tokai-student-rocket-project/H-57-Avionics/README.md

# H-57 搭載計器





TSRP-H-57に搭載する計器類のプログラム及び設計書を保存するレポジトリです。

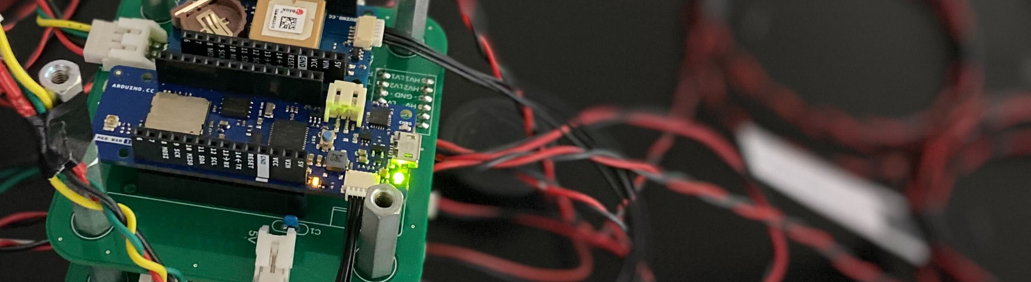
[picture p1: Documents/Images/Hero.png]
Hero


## はじめに

学生ロケットの電装系を盛り上げたい思いから、全てのソースコードを含む設計を公開しています。ガバガバ開発ですので、分かりにくい点（資料がまとまっていないなど）が多々あります。ご了承ください。

ご不明な点は以下のSNSからお気軽にお問合せください。

- X (旧Twitter): [@Tokai_SRP](https://twitter.com/Tokai_SRP)

### 計器の概要

H-57搭載計器は新型共通計器基板、テレメータ基板、バルブ制御基板および、電源基板から構成されます。

### レポジトリ構成

#### ./FlightComponents/

- [新型共通計器](./FlightComponents/CommonInstrument/README.md)   
- [テレメータ](./FlightComponents/Telemeter/README.md)  
- [バルブ制御](./FlightComponents/Telemeter/README.md) 
- 電源 

#### ./FlightResult/

- [解析資料](./FlightResult/CommonInstrument/H-57_Avionics_Analysis.md)
