tokai-student-rocket-project/H-57-Avionics/FlightComponents/Telemeter/Hardware/ServoContoroller.png

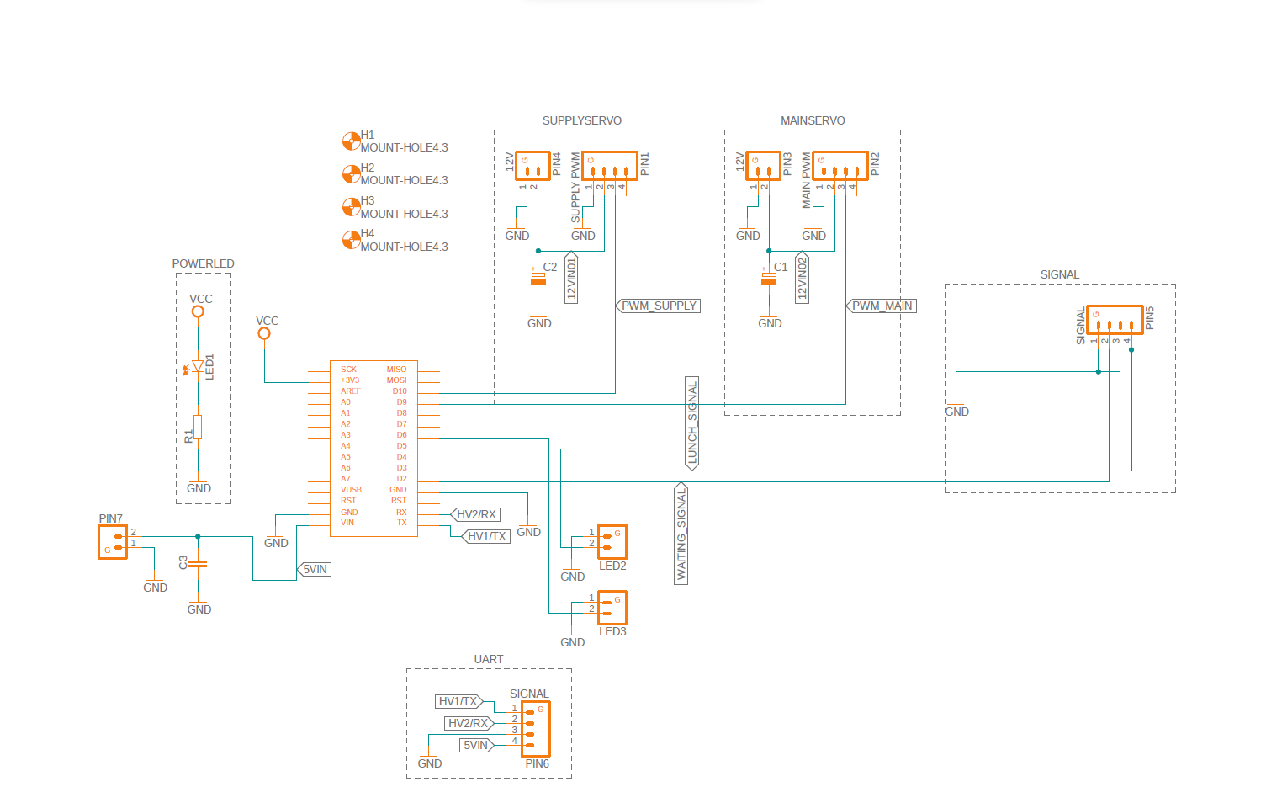
FlightComponents/Telemeter/Hardware/ServoContoroller.png
