tokai-student-rocket-project/H-57-Avionics/FlightComponents/Telemeter/Hardware/ServoController_Bottom.png

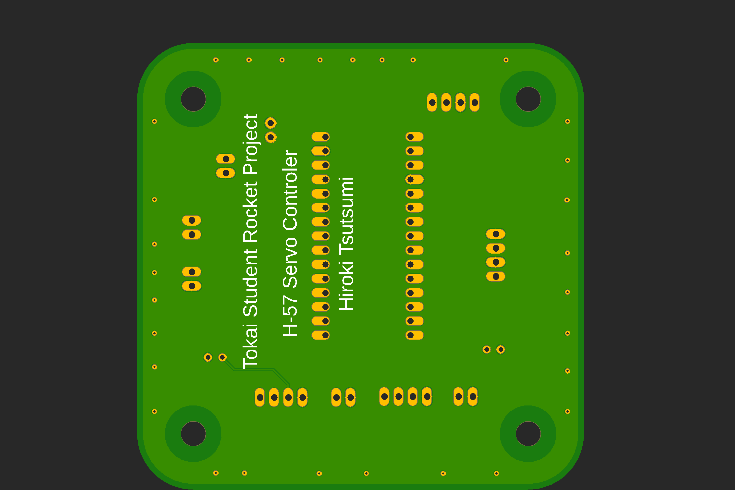
FlightComponents/Telemeter/Hardware/ServoController_Bottom.png
