tokai-student-rocket-project/H-57-Avionics/FlightComponents/Telemeter/Hardware/ServoController_Top.png

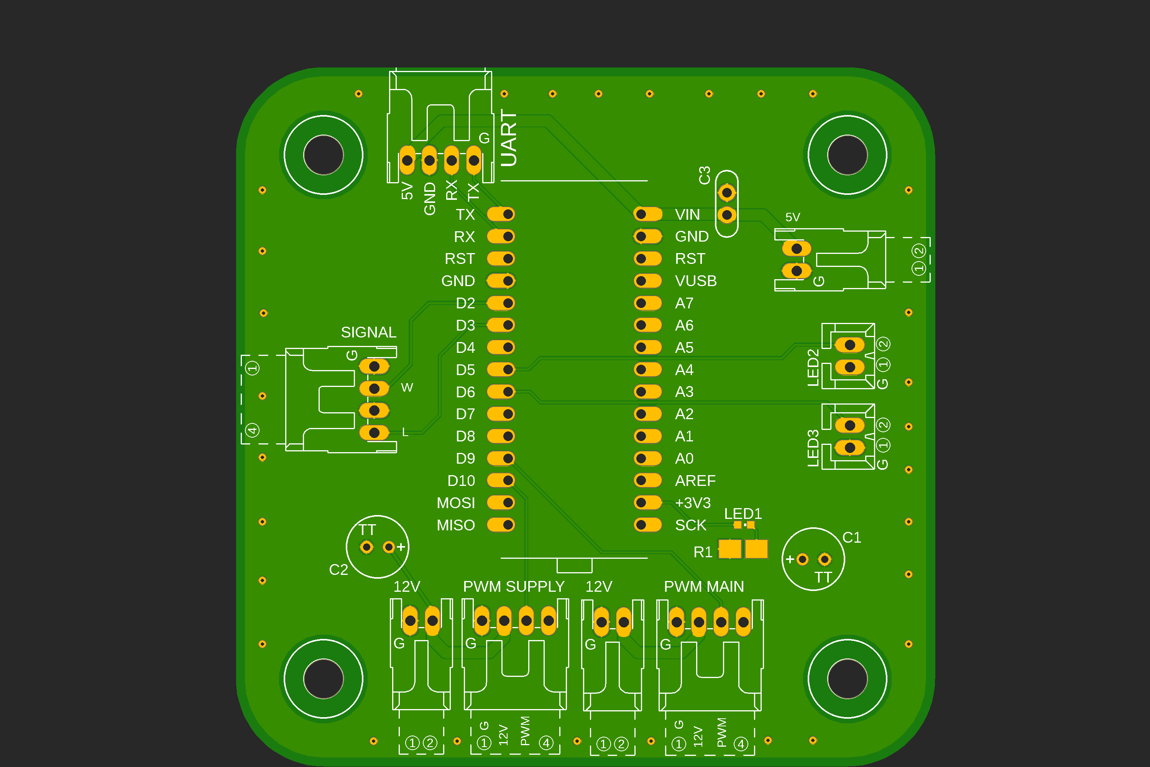
FlightComponents/Telemeter/Hardware/ServoController_Top.png
