tokai-student-rocket-project/H-57-Avionics/FlightComponents/Telemeter/README.md

# 目次

- [目次](#目次)
- [概要](#概要)
    - [目的](#目的)
    - [特徴](#特徴)
    - [成功基準](#成功基準)
- [H-57](#h-57)
  - [テレメトリー基板](#テレメトリー基板)
    - [仕様（テレメトリー基板）](#仕様テレメトリー基板)
    - [作業手順書（テレメトリー基板）](#作業手順書テレメトリー基板)
  - [バルブコントローラー基板](#バルブコントローラー基板)
    - [仕様（バルブコントローラー基板）](#仕様バルブコントローラー基板)
    - [作業手順書（バルブコントローラー基板）](#作業手順書バルブコントローラー基板)

# 概要

### 目的

- 酸化剤供給用バルブと主流路用バルブの制御を行う
- 位置情報を取得しロケットの現在地を地上に送信する

### 特徴

- 使用するマイコンボードにArduinoを採用
  
  → プログラミング初学者でも比較的作成が容易！

  → 拡張性・運用性・保守性が向上！
- LoRaWANの搭載
  - 簡単なプログラムで見通し10km以上の通信が可能
  
### 成功基準

| MINIMUM | 
| - | 
| ・GPSダウンリンク可能な機器の作成 |
| ・自作基板でのテレメーター作成 |

| FULL |
| - | 
| ・引継ぎ資料のマニュアル作成 |
| ・各種評価試験のマニュアル作成 |

| ADVANCED |
| - | 
|・送信データの種類の追加 |
|・アップリンク検証 |

[目次へ戻る](#目次)
***

# H-57

<!--何か説明やCADイメージ、現地の写真を挿入できたらいいな～-->

## テレメトリー基板

### 仕様（テレメトリー基板）

- ハードウェア

  - マイコンボード
    - [MKR WAN 1310](https://docs.arduino.cc/hardware/mkr-wan-1310)（Arduino公式HPより）
  - 動作電圧
    - USB給電：5.0V
    - 外部給電：5.0V
  - Shield
    - [MKR GPS Shield](https://docs.arduino.cc/hardware/mkr-gps-shield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.)（Arudino公式HPより）
      - バックアップ電池：CR1216

- ソフトウェア

  - 使用したライブラリ
    - [Arduino_MKRGPS.h](https://github.com/arduino-libraries/Arduino_MKRGPS)
      - MKR GPS Shield用のライブラリです。緯度、経度だけでなく受信した衛星の数や速度も取得できます。
    - [LoRa.h](https://github.com/sandeepmistry/arduino-LoRa)
      - LoRa(Low Power Wide Area)の一種。通信規格のこと。
      - LoRaで通信する際に必要なライブラリ
    - [SPI.h](https://www.arduino.cc/reference/en/language/functions/communication/spi/)
      - SPI通信をする際に必要なライブラリ
    - [ArduinoJson.h](https://github.com/bblanchon/ArduinoJson)
      - [公式HP](https://arduinojson.org/)
      - Json形式で値のやり取りができるようになるライブラリ
  - [**Inside.ino**](https://github.com/tokai-student-rocket-project/Avionics/tree/main/FlightComponents/Telemeter/Inside)
    - H-57に搭載するテレメトリー基板に使用するソースコード（名前がダサいのは直すかもしれないです...）

- 取得するデータ
  - 緯度
  - 経度
  - Epoch Time
  - 供給用バルブの角度
  - 主流路バルブの角度

- 動作
  - 電源投入後、屋外であれば3分ほど、屋内であれば7分ほどで現在の位置情報を受信開始します。
    - 正常に受信し、送信を開始するとGPS受信確認用LED（**青色**）が点滅します。
  - 各種バルブの角度は電源投入後から送信を開始します。
    - UART通信が正常に行われている場合、UART確認用LED（**緑色**）が点灯します。
  - 飛翔中に各種データの取得が可能かどうかは打ち上げを行っていない現時点では未確認です。　

### 作業手順書（テレメトリー基板）
- 事前準備

  1. USB-microB - 自身のPCにあう端子のケーブル（以後、USB-microBケーブル）、***MKR WAN 1310***、***MKR GPS Shield***を用意してください。
  2. USB-microB ケーブルを***MKR WAN 1310***に接続してください。 
  3. [Inside.ino](https://github.com/tokai-student-rocket-project/Avionics/tree/main/FlightComponents/Telemeter/Inside) を ***MKR WAN 1310*** へ書き込んで下さい。書き込み後、USB-microBケーブルを取り外してください。
  4. 基板へ iii. で書き込んだ ***MKR WAN 1310*** を**向きに気をつけて**取り付けてください。
  5. ***MKR GPS Shield*** を基板へ向きに気をつけて取り付けてください。

- タワーの組み立て
  - [こちら](./docs/Manual_Telematar.md)を参照してください。

[目次へ戻る](#目次)
***

## バルブコントローラー基板
### 仕様（バルブコントローラー基板）
- ハードウェア
  - マイコンボード
    - [ARDUINO NANO](https://docs.arduino.cc/hardware/nano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.)（Arduino公式HPより）

  - 動作電圧
    - USB給電:5.0V
    - 外部給電:5.0V
  - アクチュエータ
    - [RS-405CB](https://www.futaba.co.jp/product/robot/command_type_servos/rs405cb)（Futaba公式HPより）
      - 電源電圧:11.1[V]
      - トルク:48.0[kgf.cm]
      - スピード:0.22[s/60°]
      - 可動範囲:300[deg]
- ソフトウェア
  - [VarSpeedServo](https://github.com/netlabtoolkit/VarSpeedServo)
    - アクチュエータの角度、速度を制御します。
  - [ArduinoJson.h](https://github.com/bblanchon/ArduinoJson)
      - [公式HP](https://arduinojson.org/)
      - Json形式で値のやり取りができるようになるライブラリ

- 動作
  - GSEからの信号を取得し、バルブを制御します。
    - GSEからバルブ開の信号を取得すると供給用バルブ（常開）が**閉栓**し、主流路バルブ（常閉）が**開栓**します。
      - この状態を**Launch Mode**と呼称します。
        - Launch Mode時は状態確認用LED（**赤色**）が点灯します。
    - GSEからバルブ閉の信号を取得すると供給用バルブ（常開）が**開栓**し、主流路バルブ（常閉）が**閉栓**します。
      - この状態を**Waiting Mode**と呼称します。
      - バルブコントローラー基板起動時や特に信号がない時は**Waiting Mode**になっています。
        - Waiting Mode時は状態確認用LED（**緑色**）が点灯します。
  - UART通信用ケーブルが接続されている間はテレメトリー基板と通信を行いサーボモーターの角度を送信しています。

  工事中

### 作業手順書（バルブコントローラー基板）
- 事前準備
  1. USB-MiniB - 自身のPCにあう端子のケーブル（以後、USB-MiniBケーブル）、***Arduino NANO***を用意してください。
  2. USB-MiniB ケーブルを***Arduino NANO***に接続してください。 
  3. [ValveContoroler](/FlightComponents/Telemeter/ValveContoroler) 内にあるすべてのファイルをフォルダごとダウンロードしてください。
  4. [ValveContoroler.ino](/FlightComponents/Telemeter/ValveContoroler/ValveContoroler.ino) を ***Arduino NANO*** へ書き込んで下さい。書き込み後、USB-MiniBケーブルを取り外してください。
  5. 基板へ iv.で書き込んだ ***Arduino NANO*** を**向きに気をつけて**取り付けてください。
- タワーの組立
  - [こちら](./docs/Manual_ValveContoroler.md)を参照してください。

[目次へ戻る](#目次)

***

工事中
