tokai-student-rocket-project/H-57-Avionics/FlightComponents/CommonInstrument/docs/materials/CDR/H-57新型共通計器CDR資料.pdf

‘22年度 冬季打ち上げ CDR
H-57

# 新型共通計器

担当

岩井 祐樹 (2CEU1107)

目次

- 概要• 共通計器の目的 • 新型共通計器の特徴 • 成功基準 • 仕様• ハードウェア構成 • データ処理 • フライトモード • 分離ロジック • 通信システム
- 地上ソフトウェア • 検討事項 • 進捗状況 • ガントチャート

1/15

## 概要 / 共通計器の目的

- 分離機構に分離信号を送る
- 飛行データの取得と記録を行う

2/15

## 概要 / 新型共通計器の特徴

- マイコンにArduinoを採用

→ 拡張性・運用性・保守性が向上

- フライトモードによる指定高度分離

→ 落下分散の縮小が期待できる

- 双方向無線通信システム

→ 地上ソフトウェアを使用してコンフィグ設定・状態監視が可能

3/15

# 成功基準

- MIN: タイマーによる強制分離 • FULL: 指定高度での分離 • ADV: 双方向無線通信の正常動作

4/15

## 仕様 / ハードウェア構成

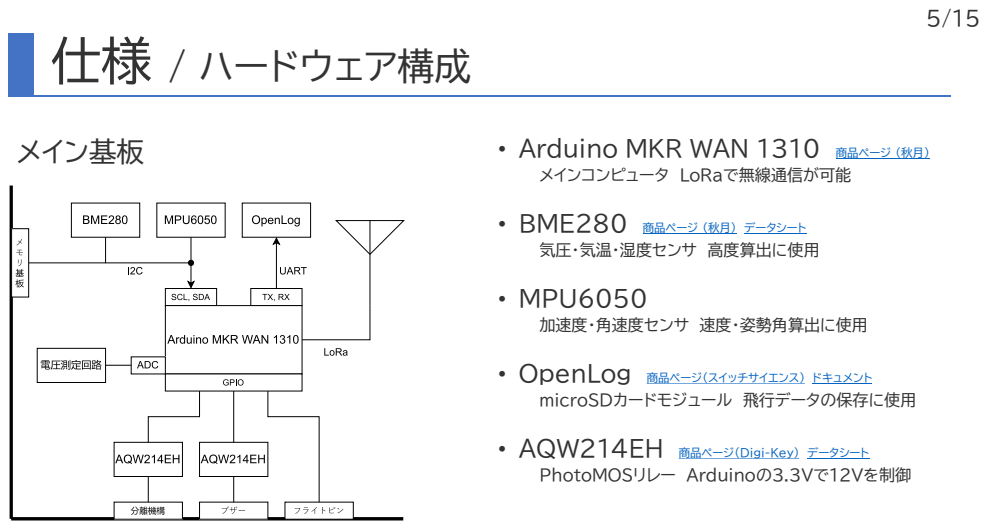
[picture p11: page 6]
メイン基板

• Arduino MKR WAN 1310 商品ページ (秋月) (https://akizukidenshi.com/catalog/g/gM-16557/)
メインコンピュータ LoRaで無線通信が可能

• BME280 商品ページ (秋月) (https://akizukidenshi.com/catalog/g/gK-09421/) データシート (https://akizukidenshi.com/download/ds/bosch/BST-BME280_DS001-10.pdf)
気圧・気温・湿度センサ 高度算出に使用

• MPU6050
加速度・角速度センサ 速度・姿勢角算出に使用

• OpenLog 商品ページ(スイッチサイエンス) (https://www.switch-science.com/products/2716) ドキュメント (https://github.com/sparkfun/OpenLog/wiki)
microSDカードモジュール 飛行データの保存に使用

• AQW214EH 商品ページ(Digi-Key) (https://www.digikey.jp/ja/products/detail/panasonic-electric-works/AQW214EH/512354) データシート (https://www3.panasonic.biz/ac/e_download/control/relay/photomos/catalog/semi_eng_ge2a_aqw21_e.pdf)
PhotoMOSリレー Arduinoの3.3Vで12Vを制御

## 仕様 / ハードウェア構成

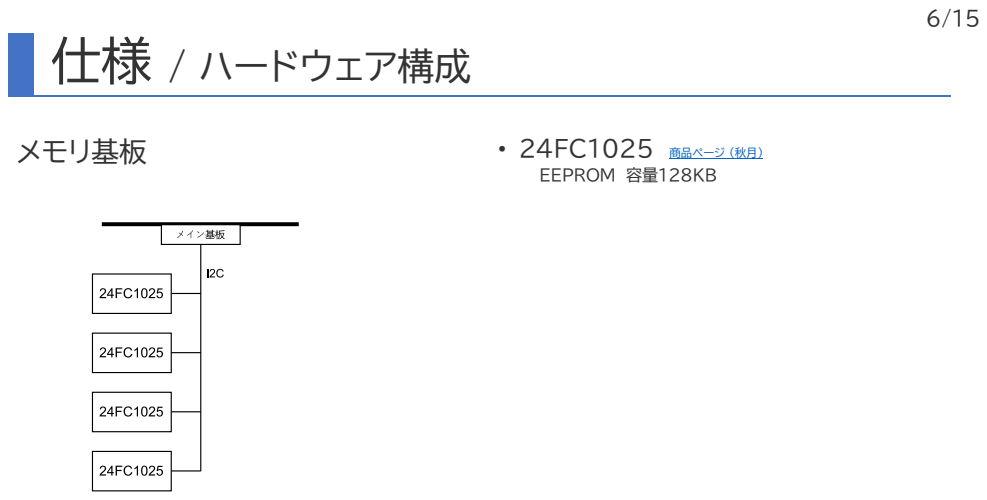
[picture p12: page 7]
• 24FC1025 商品ページ (秋月); EEPROM 容量128KB; メモリ基板

## 仕様 / ハードウェア構成

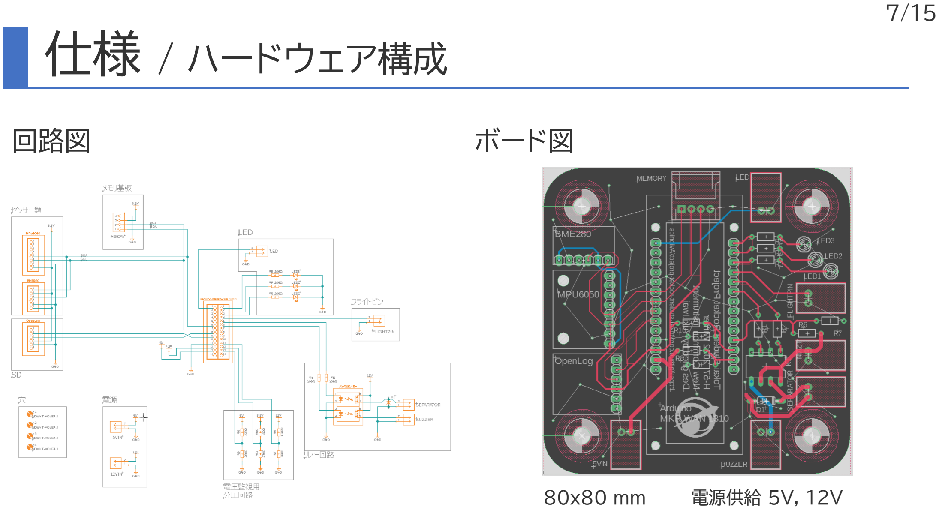
[picture p13: page 8]

ボード図

7/15

回路図

80x80 mm 電源供給 5V, 12V

## 仕様 / データ処理

8/15

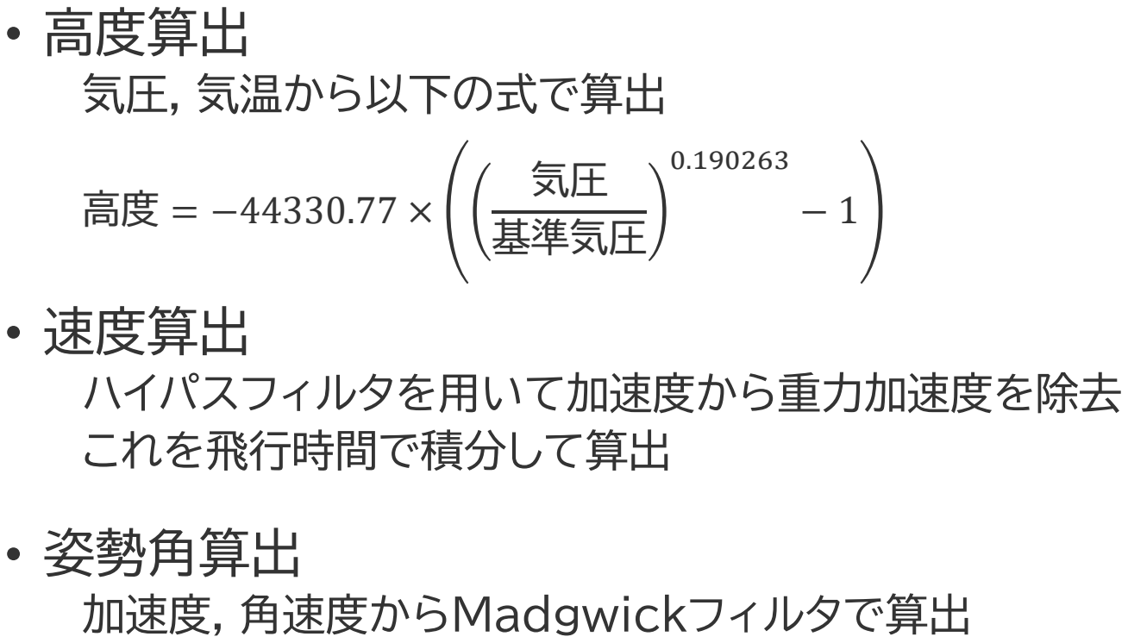
[picture p14: figure]
• 高度算出; 気圧, 気温から以下の式で算出; 気圧 基準気圧; • 速度算出; ハイパスフィルタを用いて加速度から重力加速度を除去 これを飛行時間で積分して算出; • 姿勢角算出; 加速度, 角速度からMadgwickフィルタで算出

## 仕様 / フライトモード

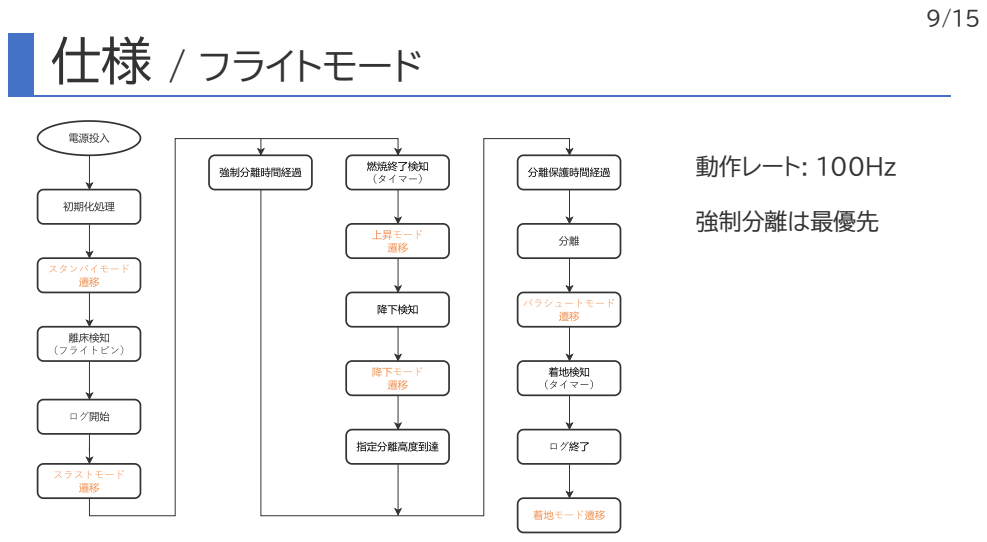
[picture p15: page 10]
動作レート: 100Hz; 強制分離は最優先

仕様

## / 分離ロジック

想定されるシナリオ

1. 正常動作
頂点で降下モード遷移
指定高度分離
2. 降下検知の感度が高すぎる
分離保護時間直後に降下モード遷移
指定高度分離
3. 降下検知の感度が低すぎる

/センサ不具合
強制分離

10/15

## 仕様 / 通信システム

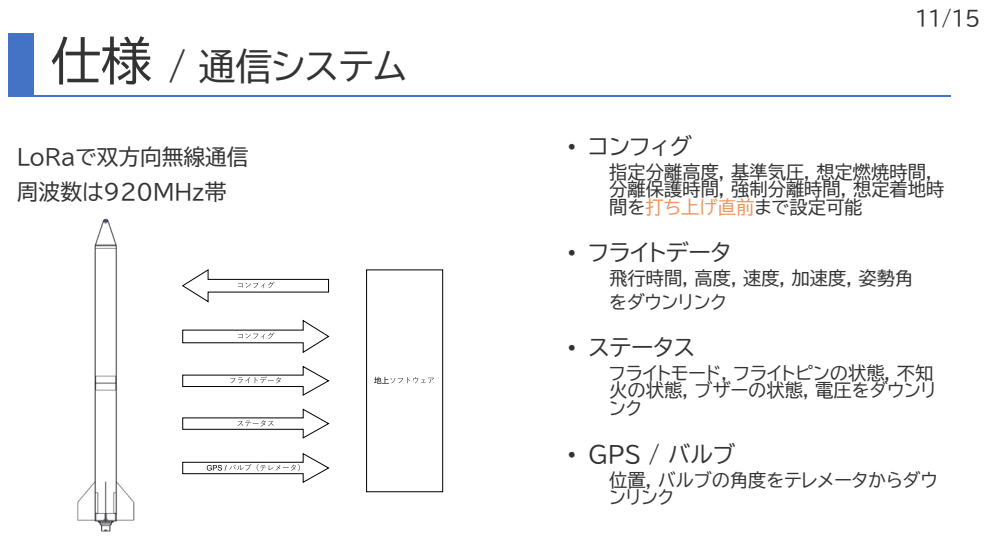
[picture p16: page 12]
LoRaで双方向無線通信; 周波数は920MHz帯

• コンフィグ
指定分離高度, 基準気圧, 想定燃焼時間,
分離保護時間, 強制分離時間, 想定着地時
間を打ち上げ直前まで設定可能
• フライトデータ
飛行時間, 高度, 速度, 加速度, 姿勢角
をダウンリンク
• ステータス
フライトモード, フライトピンの状態, 不知
火の状態, ブザーの状態, 電圧をダウンリ
• GPS / バルブ
位置, バルブの角度をテレメータからダウ
ンリンク

# 地上ソフトウェア

12/15

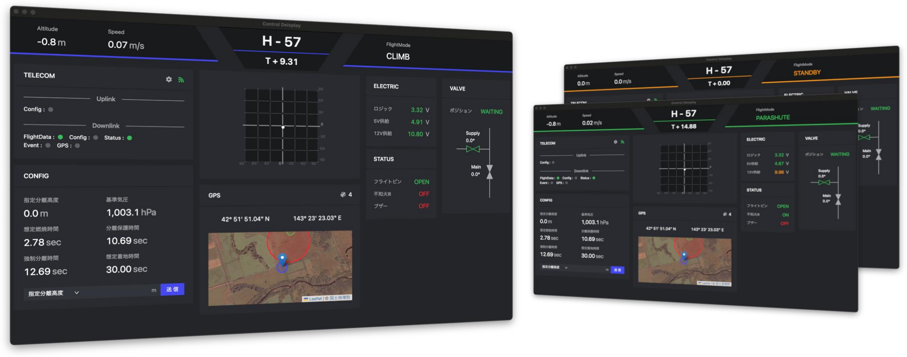
[picture p17: figure]

# 検討事項

- フライトピン （機体
)
- 各種試験の日程

1

3/15

# 進捗状況

14/15

EM完成 動作試験 | FM完成 | 各種試験

# ガントチャート

詳細はこちら (https://docs.google.com/spreadsheets/d/18oUK_KKdNqH7Yo9pZma1l5hU7nSxFkx0j7Fxe_Hdcrw/edit?usp=sharing)

15/15

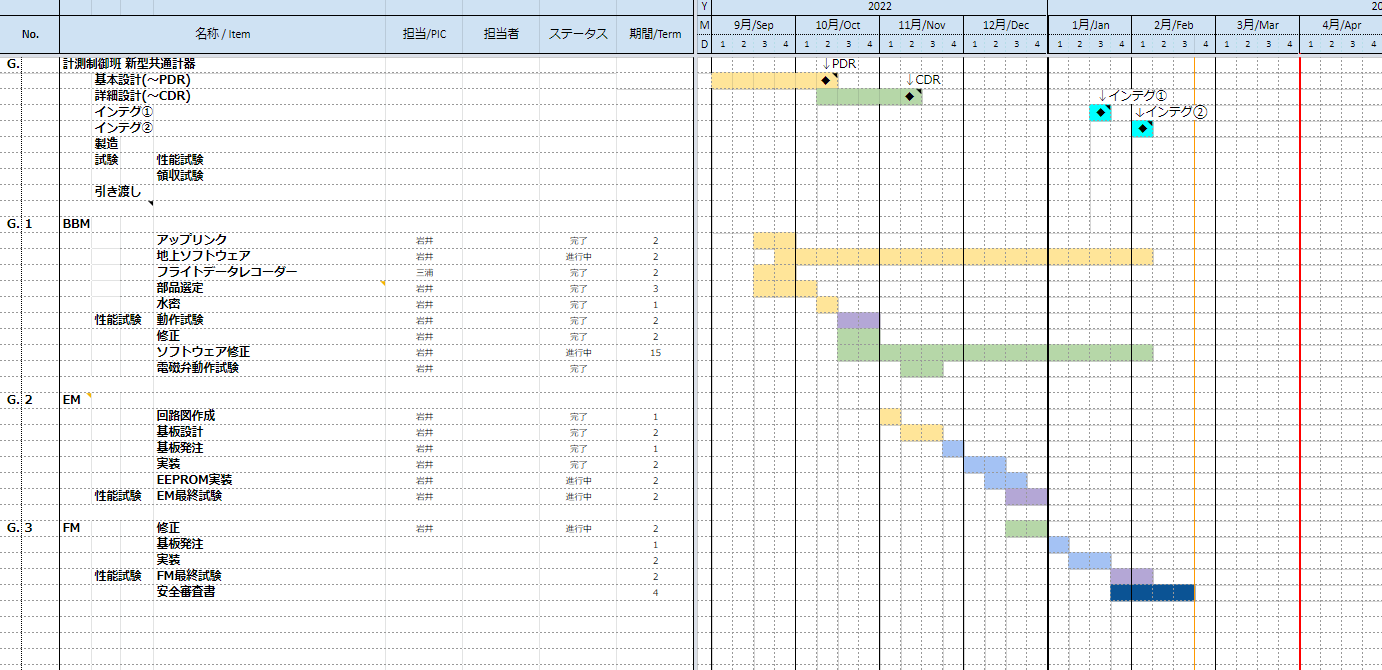
[picture p18: figure]
