tokai-student-rocket-project/H-57-Avionics/FlightComponents/CommonInstrument/docs/materials/PDR/新型共通計器PDR2022冬打ち資料.pdf

### ʻ22年度 冬季打ち上げ PDR

H-57

# 新型共通計器

担当
岩井 祐樹 (2CEU1107)

⽬次

- 概要• 共通計器の⽬的 • 新型共通計器の特徴 • 成功基準 • 仕様• ハードウェア • フライトモード • コマンド送受信

## - 検討事項 • 進捗状況 • ガントチャート

1/11

## 概要 / 共通計器の⽬的

### - 分離機構に分離信号を送る

### - ⾶⾏データの取得と記録を⾏う

2/11

## 概要 / 新型共通計器の特徴

### - マイコンにArduinoを採⽤

→ 拡張性・運⽤性・保守性が向上

### - フライトモードによる指定⾼度分離

→ 落下分散の縮⼩が期待できる

### - 双⽅向無線通信によるコマンド送受信

→ 対話的に設定・⾃⼰診断・⼿動分離が可能

3/11

# 成功基準

### - MIN: タイマーによる分離信号

### - FULL: フライトモードによる分離信号

### - ADV: コマンド送受信

4/11

## 仕様 / ハードウェア

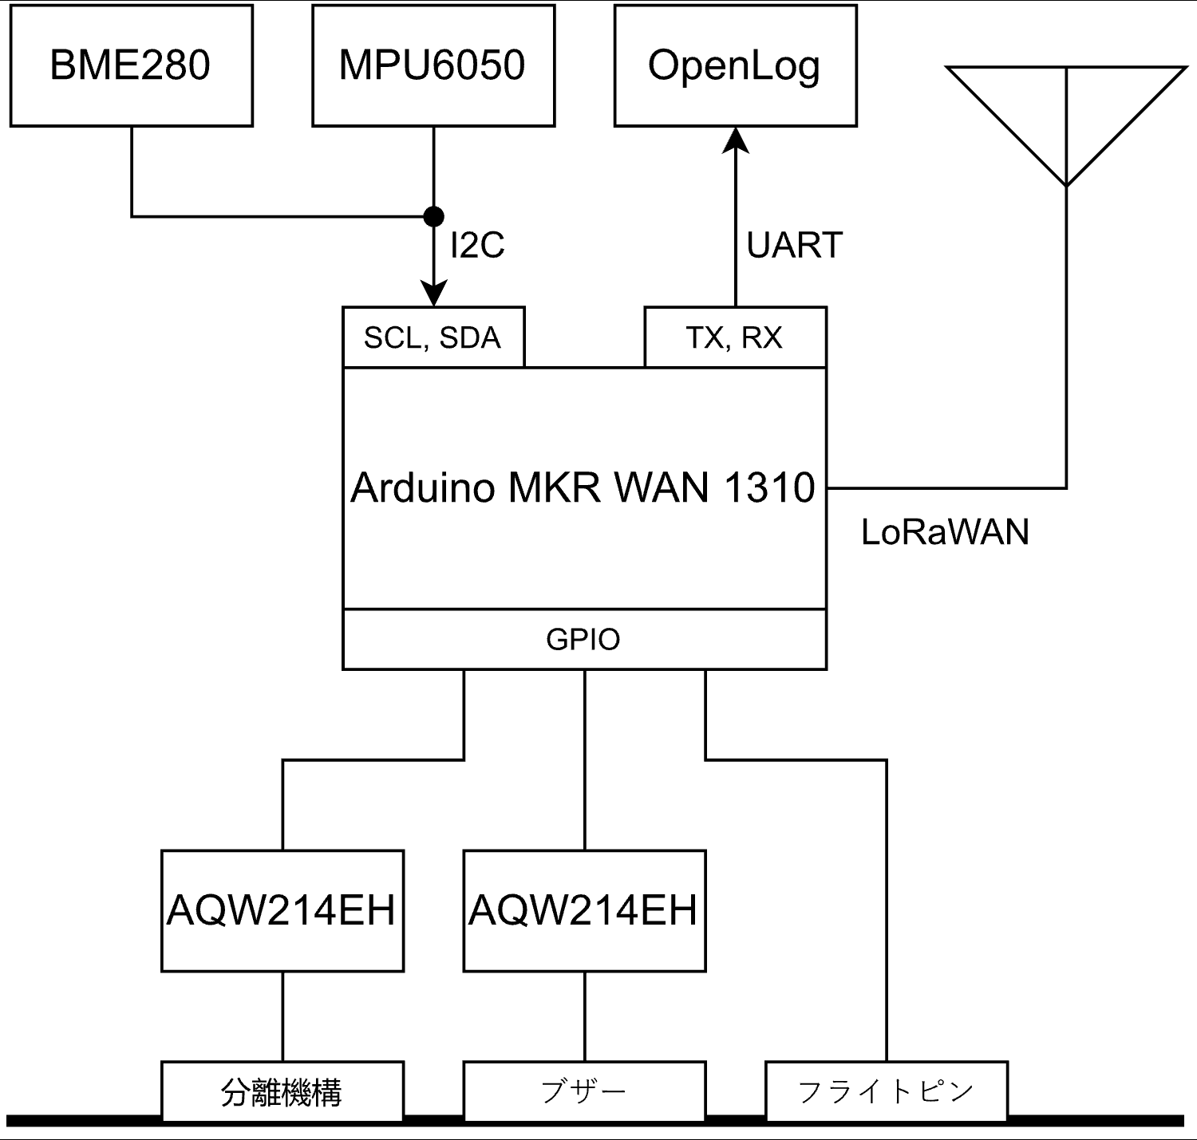
[picture p19: figure]

- Arduino MKR WAN 1310 商品ページ (秋⽉) (https://akizukidenshi.com/catalog/g/gM-16557/)

無線通信ができるArduino

- BME280 商品ページ (秋⽉) (https://akizukidenshi.com/catalog/g/gK-09421/) データシート (https://akizukidenshi.com/download/ds/bosch/BST-BME280_DS001-10.pdf)
気圧・気温・湿度センサ ⾼度算出に使⽤
- MPU6050

加速度・⾓速度センサ 姿勢⾓算出に使⽤

- OpenLog 商品ページ(スイッチサイエンス) (https://www.switch-science.com/products/2716) ドキュメント (https://github.com/sparkfun/OpenLog/wiki)

microSDカードモジュール ⾶⾏データの保存に使⽤

- AQW214EH 商品ページ(Digi-Key) (https://www.digikey.jp/ja/products/detail/panasonic-electric-works/AQW214EH/512354) データシート (https://www3.panasonic.biz/ac/e_download/control/relay/photomos/catalog/semi_eng_ge2a_aqw21_e.pdf)
PhotoMOSリレー Arduinoの3.3Vで9Vを制御

5/11

## 仕様 / ハードウェア

6/11

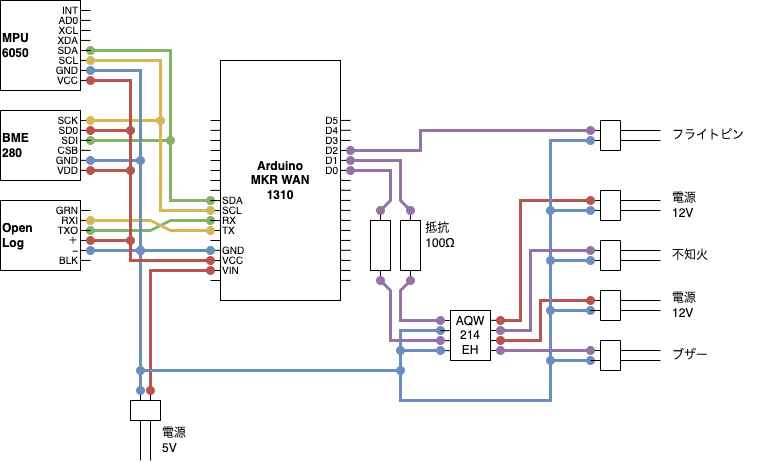
[picture p20: figure]

仕様

## / フライトモード

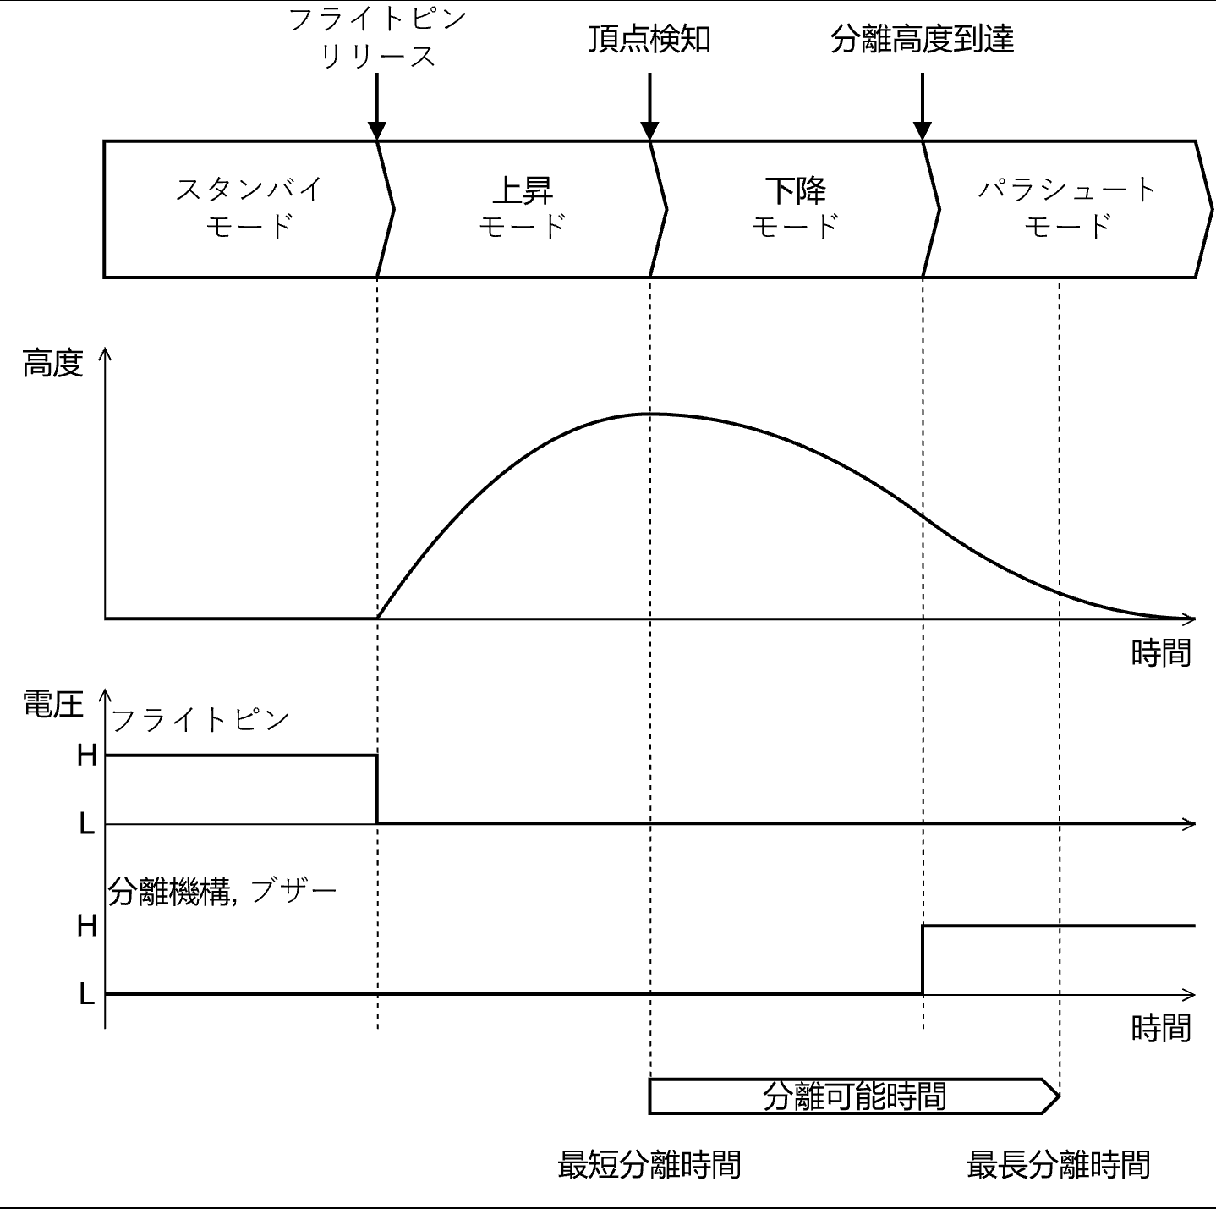
[picture p21: figure]

4つのモードからなるフライトモードを実装

条件を満たすと次のモードに移⾏

燃焼中や上昇中の分離を防ぐために最短分
離時間を設定
モード移⾏失敗に備えて最⻑分離時間を設 定, この時間になると状況にかかわらず強制

的に分離信号を出す

最短分離時間

と最⻑分離時間の間に分離⾼
度に達すると分離信号を出す

7/11

## 仕様 / コマンド送受信

ロケットと地上でコマンドを送受信する.地
上からロケットへのリクエストに対してロ
ケットは地上にレスポンスを返す.

8/11

⾼度算出に使⽤する基準気圧の設定,
センサなどの機器が正常に動作して
いるかを確認するヘルスチェックな
どを実装.

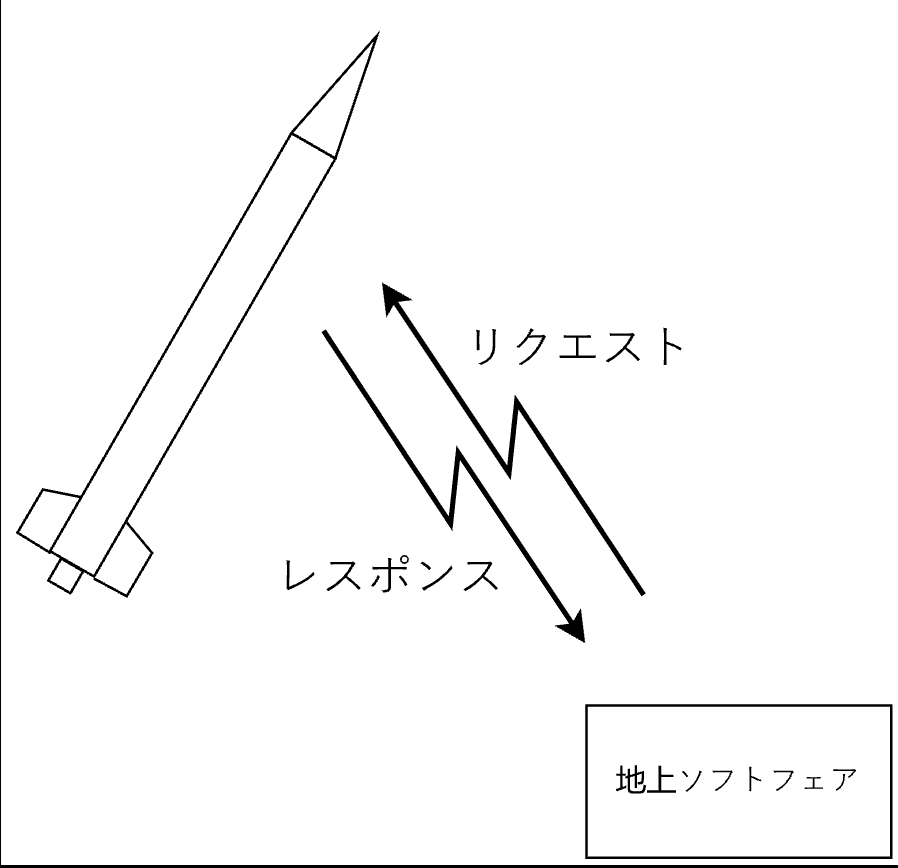
[picture p22: figure]

コード | 内容
0x01 0x02 0x03 0x04 | 初期化 ヘルスチェック 基準気圧設定 ⼿動分離

# 検討事項

- 電源
1 x 5V
2 x 12V
- 基板形状 (エレキ)
80mm x 80mm

### - フライトピン （機体）

- 防⽔⽅法 (エレキ・機体)
⽔密

### - アンテナ・ブザー固定⽅法 (エレキ・

機体)

9/11

# 進捗状況

10/11

ブレッドボードモデル | 基板設計 | 基板製造

### 今後（数年）に向けて

- 地磁気センサを⽤いた正確な姿勢⾓算出
- コマンド送信・位置情報・軌道予測表⽰ができる統合管制アプリケーションの開発

# ガントチャート

詳細はこちら (https://docs.google.com/spreadsheets/d/18oUK_KKdNqH7Yo9pZma1l5hU7nSxFkx0j7Fxe_Hdcrw/edit?usp=sharing)

11/11

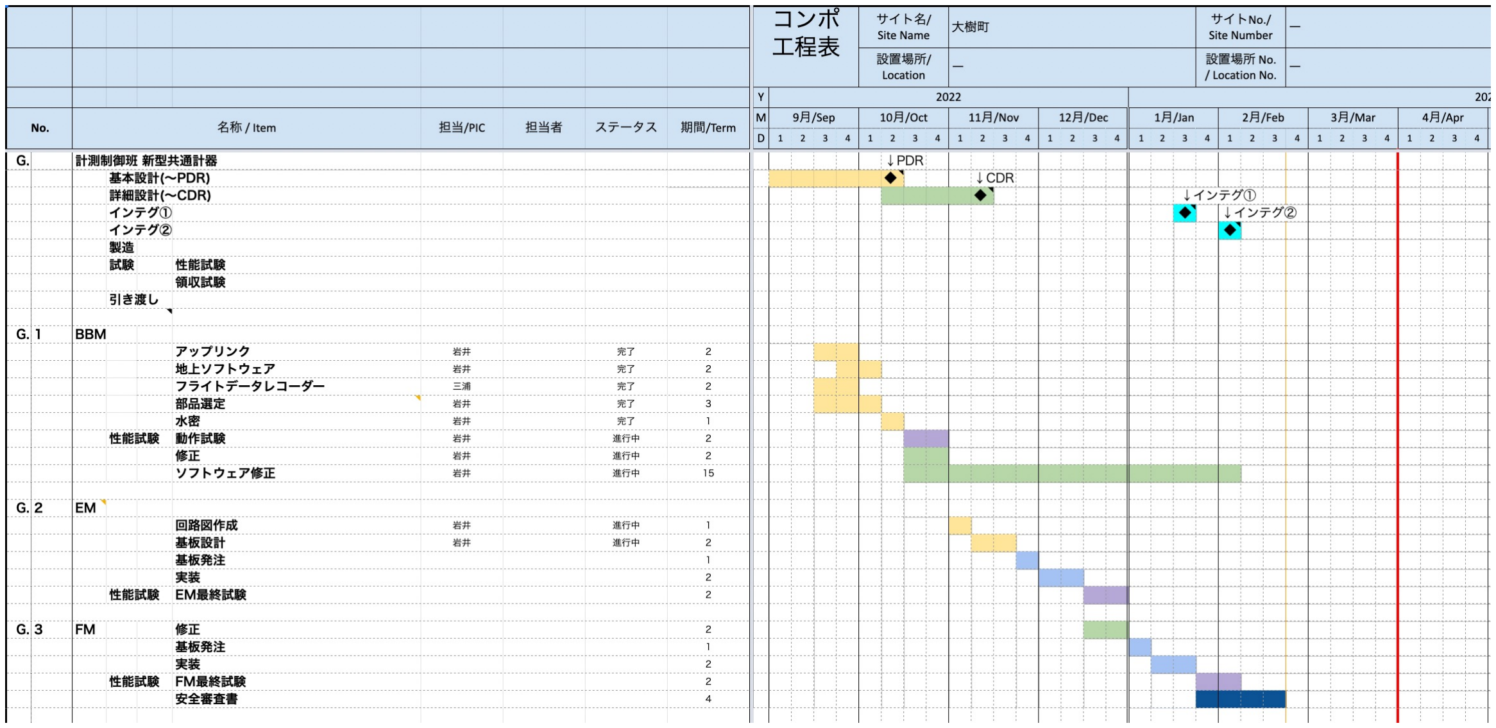
[picture p23: figure]
