tokai-student-rocket-project/H-57-Avionics/ExperimentalComponents/SixAxisSensor/README.md

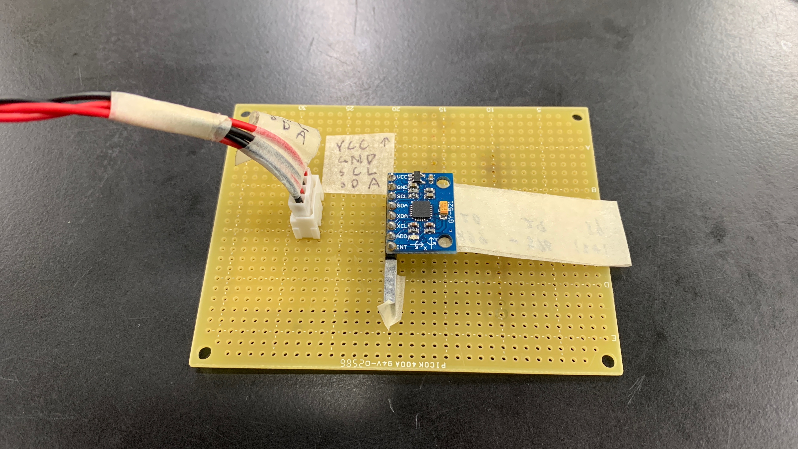
[picture p25: ExperimentalComponents/SixAxisSensor/docs/images/Slave.jpg]

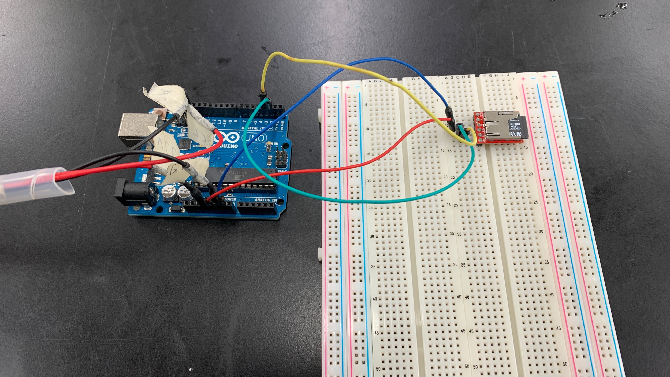
[picture p26: ExperimentalComponents/SixAxisSensor/docs/images/Master.jpg]
