tokai-student-rocket-project/H-57-Avionics/FlightComponents/List_20230220.md

# 渡航に必要なものリスト

## 2022年度 北海道広尾郡大樹町打ち上げ実験用

渡航に必要なものをここに記す

### 実際に用意したもの
| 名称 | 【企業名】 | (個数/在庫=所持している分) | 参考リンク |
| ---- | --- | --- | --- |

<br><br>
- [ ] :point_left: **_E0_**　**風向風速計ケース(1217W×500D×43H)** 

 - [ ] :+1:風向風速計セット　<全てケースや箱込み>【HOBO】　(x1)
   - [ ] データロガー
     - [ ] :octocat:ロガー本体　(×1) <2420ℊ>
     - [ ] ロガー専用充電器  (×1) <400g> →　コネクタBOX2に収納
   - [ ] 各種センサ
     - [ ] 風向風速計　(×1)　<1895ℊ>
     - [ ] 温度計　(×1)　<105ℊ>
     - [ ] 圧力計　(×1)　<115ℊ>
     - [ ] 雨量計　(×1)　<1280ℊ>
   - [ ] 各種ねじ等　<1055ℊ> 
   - [ ] 各種取り付け治具
     - [ ] ペグ　(×3) <280ℊ>
     - [ ] Solar Radiation Shield　(×1)　<175ℊ>
     - [ ] 四角アルミ　(×1)　　<1140ℊ>
     - [ ] 支柱本体　<合計：6025ℊ>
   - [ ] 各種取り付け工具
     - [ ] レンチ（規格：13）【メカ班のものを借用】 (×1)　<85ℊ>
     - [ ] レンチ（規格：11）【以下同文】　(×1)　<65ℊ>
     - [ ] レンチ（規格：10）【以下同文】　(×1)　<45ℊ>
     - [ ] レンチ（規格：13-11）【以下同文】(×1)　<65ℊ>
     - [ ] レンチ（規格：12-10）【以下同文】(×1)　<65ℊ>
     - [ ] モンキーレンチ（規格：250mm）【以下同文】(×1)　<395ℊ>
     - [ ] ハンマー　【以下同文】(×2)　<~290~ℊ>
       - [ ] 金属製ハンマー　【以下同文】
       - [ ] ゴム製ハンマー　【以下同文】 
     - [ ] :octocat:電動ドライバーセット　【BLACK＋ DECKER】　(×1)　<充電器やビット込み：615ℊ>　
     
   - [ ] :octocat:TOUGHPAD一式【Panasonic】 <ハードケース，充電器込み：1290ℊ>
   - [ ]  ~~現場猫　Ver.招き猫　(×1)　<480ℊ>~~
   - [ ] :octocat:充電池セット　<1560ℊ>
   - [ ] 元熱収縮チューブ箱　<670ℊ>
     - [ ] 熱収縮チューブ
     - [ ] コネクタ(オス・メス)　(×2)　（コンタクタ）【ヒロセ電機】(在庫) [MiSUMi](https://jp.misumi-ec.com/vona2/detail/222000425951/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)
   - [ ] :octocat:デジタルマルチメーター ＜435ℊ＞
   - [ ] コネクタボックス1　<195ℊ>　（コンタクタ）【ヒロセ電機】(在庫) [MiSUMi](https://jp.misumi-ec.com/vona2/detail/222000425951/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)
   - [ ] コネクタボックス2　<800ℊ>　（コンタクタ）【ヒロセ電機】(在庫) [MiSUMi](https://jp.misumi-ec.com/vona2/detail/222000425951/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)
   - [ ] :octocat:SONYカメラ　<980ℊ>
       * 充電池も一緒に運搬(予定)
   - [ ] プロジェクター　一式　<2965ℊ>
   - [ ] :octocat:マルチメーター　<305ℊ>
   - [ ] :point_left: 養生テープ <170g>
   - [ ] 青ケース　<1465ℊ>
   - [ ] ~~専用充電器　(×1)　【Ryobi】　<375ℊ>~~
   - [ ] :point_left:三脚　(×6)【指定なし】　<合計:　~~6048~~  Kg>
     - [ ] 三脚　【SLIK F147】 <952ℊ>
     - [ ] ~~三脚　【HAKUBA　HP-321B】　<1314ℊ>~~
     - [ ] 三脚　【MADE IN CHINA】 <694g>
     - [ ] ~~三脚　【FT-367】 <1112ℊ>~~
     - [ ] 三脚　【Velbon　Light 450-D】　<976ℊ>
     - [ ] 三脚　【Kenko　ZF-400 WSH】　<1000ℊ>
   - [ ] :point_left:外部給電用ラックセット　<g>
     - [ ] 留め具　<45g> →　元熱収縮チューブ箱へ収納
     - [ ] 荷造りロープ　<155g>
     - [ ] ジョイントラック　(×3) <1320g>
     - [ ] ポール小　(×4)　360g　
     - [ ] ポール中　(×4)　560g
     - [ ] ポール大　(×4)　640g　
     - [ ] テーブルクロス　(×3) 520g
     - [ ] 予備部品　25g 
   - [ ] :point_left:POEカメラ【指定なし】(x2) 　<2554ℊ:三脚込み>
     - 充填確認用
    
   - [ ] :point_left::octocat:ビデオカメラBOX【指定なし】(x1)　<1026ℊ>
   
 <br><br><br><br>
- [ ] :+1:**_E1 エレキ工具箱_** **(23W×49D×29H)**　<内容物なし：6765ℊ>　

  - [ ] ワイヤーストリッパー【HOZAN & SKII】(在庫)　(×3)　<340ℊ>
  - [ ] はんだごて【HOZAN】(在庫)　(×4)　<540ℊ>
  - [ ] はんだ吸い取り線【太陽電機産業】(在庫)
  - [ ] 圧着工具【エンジニアー】(在庫)　(×3)　<405ℊ>
  - [ ] 圧着工具(大)【HOZAN】(x1)　<430ℊ>
    - イグナイター用線材の補強用
  - [ ] ニッパー【エンジニアー】(x1)　<40ℊ>
  - [ ] ニッパー【金属用なら指定なし】(x2)　<65ℊ>
  - [ ] :octocat:マルチメーター　(細)
  - [ ] その他物品　<色々込み：640ℊ>
    - [ ] こて先【HAKKO】(在庫)
    - [ ] ピンセット【太陽電機産業】(x1)　
    - [ ] :+1:ピンセット【HAKKO】(x1)
      - [ ] ピンセットの先【HAKKO】(x2)
   
  - [ ] はさみ (×1)　<45ℊ>
  - [ ] 六角レンチ (×1)　<330ℊ>
  - [ ] プラスドライバー (×4)　<360ℊ>
  - [ ] LANケーブル圧着工具　(×2)　<760ℊ>
  - [ ] LANケーブル被膜むき器　(×1)　<55ℊ>
  - [ ] ドリル刃セット　(×1)　<ケース込み：175ℊ>
  - [ ] :point_left: ビット変換可能ドライバー【指定なし】(x2)　<ケース込み：450ℊ>　
  - [ ] グルーガン
 
  - [ ] 布絶縁テープ【指定なし】(x1) <86ℊ>
    - 燃焼班が使うこともあるため多めに
    - もう一つは電気推進室で確認
  - [ ] :point_left:マスキングテープ【指定なし】(x3)　<60ℊ>
  - [ ] :+1:はんだ【指定なし】(在庫)　<合計：>
    - [ ] 糸はんだ　<105ℊ>
    - [ ] 鉛入りはんだ　<320ℊ>
        - 所持していれば
    - [ ] :point_left:鉛フリーはんだ　<810ℊ>
  - [ ] タイラップ
  - [ ] やすりセット
  - [ ] LANコネクタ　

<br><br>
- [ ] :point_left:**_E2　ジュラルミンケース_**　**(42W×25D×325H)**<内容物込み：6.0Kg>

  - [ ] :+1:~~線材【協和ハーモネット】(在庫) [モノタロウ](https://www.monotaro.com/p/6242/6264/)　<合計:2550ℊ>~~　→個人個人で所持に変更
    - [ ] ~~赤（AWG24）(×1)~~
    - [ ] ~~黄（AWG24）(×1)~~
    - [ ] ~~緑（AWG24）(×1)~~
    - [ ] ~~青（AWG24）(×1)~~
    - [ ] ~~黒（AWG24）(×1)~~
  
  - [ ] :point_left:クランプ台 <390g>
  - [ ] :point_left:はんだごて台　(×2)　<730ℊ>
  - [ ] :point_left:クリーニングワイヤー　(×2)　<ケース付き:110ℊ>
  - [ ] :point_left:ケーブルまとめる奴　<310ℊ>
  - [ ] キムワイプ　(×2)　<210ℊ>
  - [ ] アンビリカブルケーブル　(×2)
     - [ ] LGBTQ<sup>+</sup>ケーブル　(カラフル)
     - [ ] 脱圧用ケーブル　(灰色)
  - [ ] ケーブル固定用部品　(白)
  - [ ] 予備線

<br><br>
- [ ] :point_left:**_E3　部品BOX_**　**(375D×510W×88H)**

  - [ ] :+1:FM基板用予備部品【仕様に応じて】(在庫)　<救出セットも込み1926ℊ>
    - [ ] ダイオード
    - [ ] アルミ電解コンデンサ
    - [ ] セラミックコンデンサ 
       - 大実から持ってくる　
    - [ ] LED
    - [ ] レベル変換キット
    - [ ] EEPROM
    - [ ] フォトリレー
    - [ ] MPU6050
    - [ ] BME280
    - [ ] OpenLog
    - [ ] 抵抗
    - [ ] ICソケット
    - [ ] ピンソケット
    - [ ] プラスチックスペーサー
    
  - [ ] :+1:EEPROM救出セット【仕様に応じて】
    - [ ] ブレッドボード【指定なし】(x3)
    - [ ] Arduino UNO【Arduino】(x2)
    - [ ] ジャンパ線【指定なし】(在庫)

  - [ ] :point_left:ポリアミド線【指定なし】(在庫)

  - [ ] :point_left:イグナイター用の予備クランプ
    - 過去に破損した例あり
  - [ ] :point_left:電源部品セット　<575ℊ>
  - [ ] 基板取付用CR123A電池ケース
  - [ ] :point_left: Arduino NANO【Arduino】(x1)
  - [ ] :point_left:Arduino MKR WAN1310【Arduino】(x4)
    - ~2023/2/15現在届いていない~　届きました
  - [ ] :point_left:Arduino MKR GPS Shield 【Arduino】(×1) 
  - [ ] 赤コネクタ【日本圧着端子】　(在庫)
  - [ ] コネクタ　【HIROSE】
  - [ ] 圧着端子
  - [ ] :point_left: アンテナ　(×4)

<br><br>
- [ ] :point_left:**_E4　ジュラルミンケース_**　**(505W×205D×255H)**

  - [ ] :+1:FM基板【PCBGOGO】(在庫)
    - [ ] 電源制御基板 (EM×2,FM×1)
    - [ ] 電池BOX基板
    - [ ] テレメトリー基板
    - [ ] 共通計器基板　(EM×1,FM×1)
    - [ ] サーボコントローラー基板
    - [ ] ~~アンテナ~~ :arrow_right:E3に移動
    - [ ] :+1: 各種配線
      - [ ] ~~赤コネクタ【日本圧着端子】(在庫)~~　:arrow_right: E3へ移動
    - [ ] :point_left:各種LED
       -  火星人の脊髄の末端に存在
  - [ ] :octocat:CR123A 電源基板用電池　【Fujitu・Panasonic】　(×65)
  - [ ] :point_left: 火星人の脊髄抜いてみた
  - [ ] :point_left: 基板　(未実装)
  - [ ] :point_left: 地上局
  - [ ] :point_left: 地上局用ケーブル　【Type-C/micro-B】(×2)
  - [ ] サーボモーター予備
 
<br><br>
- [ ] :point_left:**_E5 青BOX_**　**(404W×605D×303H)**　<ケース:4.5Kg>
 
  - [ ] :point_left: 安定化電源【菊水、~~A&D~~】(x1)　<6385ℊ>
  - [ ] :point_left: モニター　~~【EIZO】　<6640ℊ>~~ :arrow_forward: 軽量化のため、【BENQ】　<3500ℊ>　に変更
  - [ ] :point_left: 電源ケーブル　(×2)
     - [ ] ~~EIZO~~BENQ用電源ケーブル
     - [ ] 安定化電源用ケーブル
  - [ ] :point_left: D-Sub/HDMIケーブル　(私物:堤)
  - [ ] :point_left: リレーモジュール
  - [ ] :point_left: 脱圧モジュール　(12V，ACアダプター含む)
  - [ ] :point_left:スイッチングハブ　(×1)　<582ℊ>
     -  POEカメラ用
    
  - [ ] :point_left:POEカメラ制御機器　(×1)　<808ℊ>
 
 <br><br>
- [ ] :point_left: **_その他_**

  - [ ] :point_left:ヒートガン【HAKKO】(x1)　<990ℊ：箱込み>
  
  - [ ] :point_left:電動はんだ吸い取り機【HAKKO】(x1)　<1.6Kg：ケース込み>
 
  - [ ] :point_left:LANケーブル【指定なし】(x2)　<合計:8700ℊ>
    - 50mリールが2本　<4500ℊ，4200ℊ>
    - 充填確認用POEカメラ用
     
  - [ ] :+1:~~電動ドリル【Ryobi】(x1)　<3075ℊ：ケース，バッテリー込み>~~
    - [ ] ~~:octocat:専用バッテリー【Ryobi】(x2)~~
       
  - [ ] :point_left:~~エレキねじBOX~~　:arrow_forward:<2820g→215ℊ>

  - [ ] :point_left:丸形圧着端子【特に指定なし】(在庫) :arrow_forward: 燃焼班が所持
---

**追加物品**

- [ ] :point_left:モニター　(×1)　
  - [ ] ~~モニター　【EIZO】　<6640ℊ> 　:arrow_right:　E5に追加~~
  - [ ] ~~モニター　【DELL】　<4500ℊ> :arrow_right: コンテナに入るかどうか判断~~
  - [ ] モニター　【BENQ】　<3500ℊ> :arrow_right: E5に追加
  - [ ] ~~モニター　【MITSUBISHI】　<7000ℊ> :arrow_right: コンテナに入るかどうか判断~~
  - [ ] ~~モニター用電源ケーブル　(×1d) <1000g>　:arrow_right: 上記のモニター次第~~
- [ ] :point_left:　~~HDMIケーブル　(×4)　<500ℊ>~~ :arrow_forward:各自で持参
- [ ] :point_left:　
- [ ] :point_left:　
- [ ] :point_left: 
- [ ] :point_left:
- [ ] :point_left:
- [ ] :point_left:
- [ ] :point_left:
- [ ] :point_left:
- [ ] :point_left:
- [ ] :point_left:
- [ ] :point_left:
- [ ] :point_left:
- [ ] :point_left:
- [ ] :point_left:
- [ ] :point_left:
- [ ] :point_left:
- [ ] :point_left:
- [ ] :point_left:
- [ ] :point_left:
- [ ] :point_left:
 <br>
※ 電池が入っている物品には :octocat: をつけています。

#### E0 風向風速計ケース　合計50.842　　Kg
#### E1 エレキ工具箱　合計　14.3　Kg
#### E2 ジュラルミンケース　合計　6.0　Kg
#### E3 部品BOX　合計　2.8　Kg
#### E4 ジュラルミンケース 合計　7.6　Kg
#### E5 青BOX　合計　17.8　Kg
#### その他　合計　11.505　Kg
#### 追加物品　合計　0　Kg
<br>
 
## 計測制御班 合計　110.847　Kg  
 
---

- [ ] 1回目の:point_left:ヨシ！ 堤
- [ ] 2回目の:point_left:ヨシ！ 岩井
- [ ] 3回目の:point_left:ヨシ！ 内田

確認

## 持っていきたい暇つぶし道具

---
## 渡航にあるとよかったもの:+1:

---
## 渡航に必要なかったもの:-1:

---
