tokai-student-rocket-project/H-57-Avionics/FlightResult/Motion/Assets/CSVSerializer/Demo/const.csv

id | value
maxhp | 200
type | wolf
intarray | 10,20,30
floatarray | 10,1
stringarray | bigmac,inandout
