tokai-student-rocket-project/H-57-Avionics/FlightComponents/CommonInstrument/docs/images/wirering-diagram-dark.png

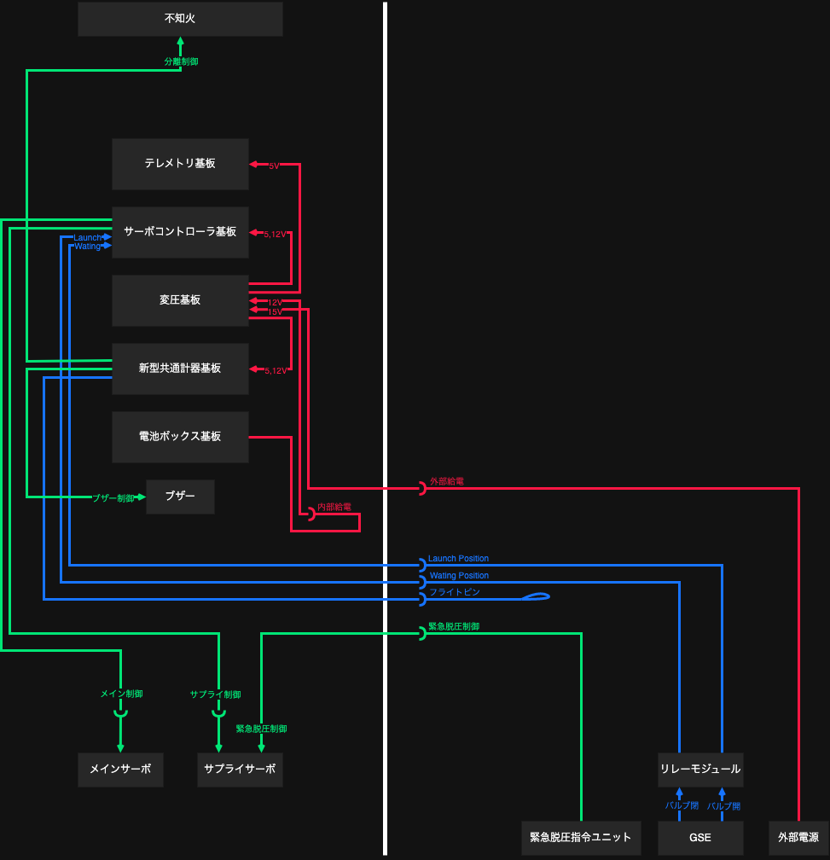
FlightComponents/CommonInstrument/docs/images/wirering-diagram-dark.png
