tokai-student-rocket-project/H-57-Avionics/FlightComponents/CommonInstrument/docs/materials/SafetyReview/TimingDiagram.drawio.png

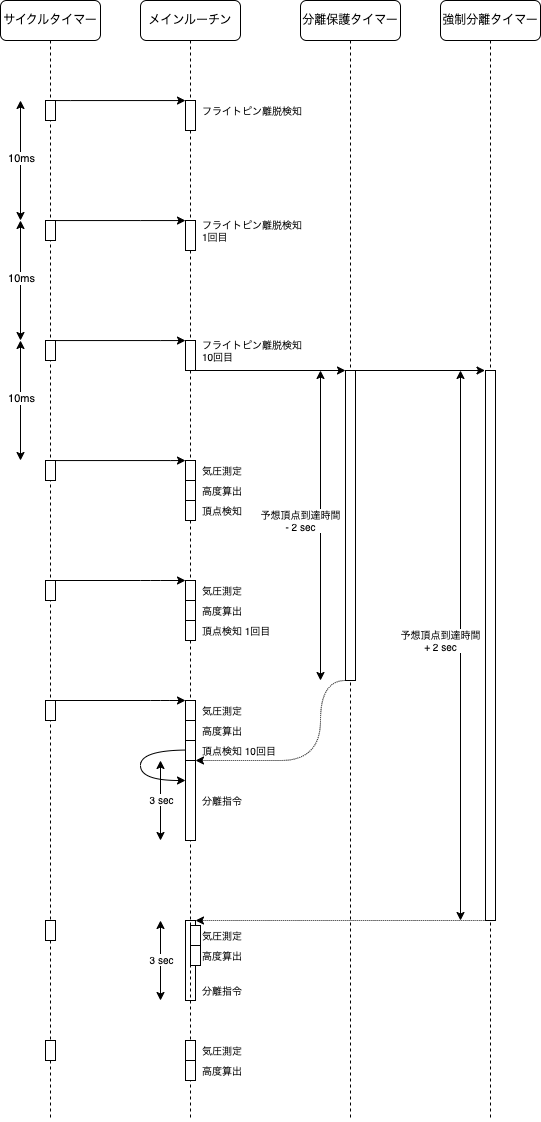
FlightComponents/CommonInstrument/docs/materials/SafetyReview/TimingDiagram.drawio.png
