tokai-student-rocket-project/H-57-Avionics/FlightComponents/CommonInstrument/Ground/ControlDisplay/src/renderer/images/ball/ball-bottom.png

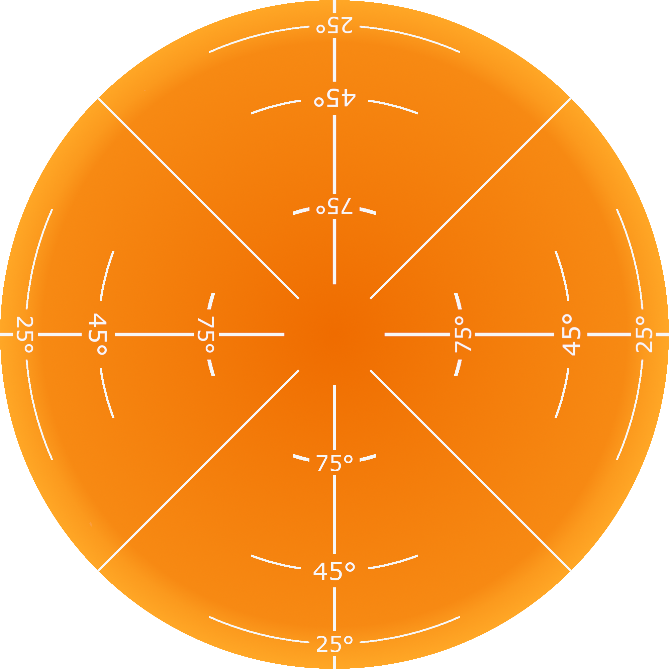
FlightComponents/CommonInstrument/Ground/ControlDisplay/src/renderer/images/ball/ball-bottom.png
