tokai-student-rocket-project/H-57-Avionics/FlightComponents/CommonInstrument/Ground/ControlDisplay/src/renderer/images/valve/mcsc.png

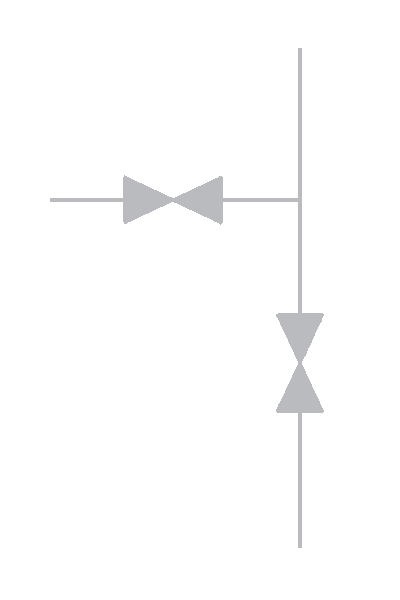
FlightComponents/CommonInstrument/Ground/ControlDisplay/src/renderer/images/valve/mcsc.png
