tokai-student-rocket-project/H-57-Avionics/FlightComponents/Telemeter/docs/images/RGB_Avionics.jpg

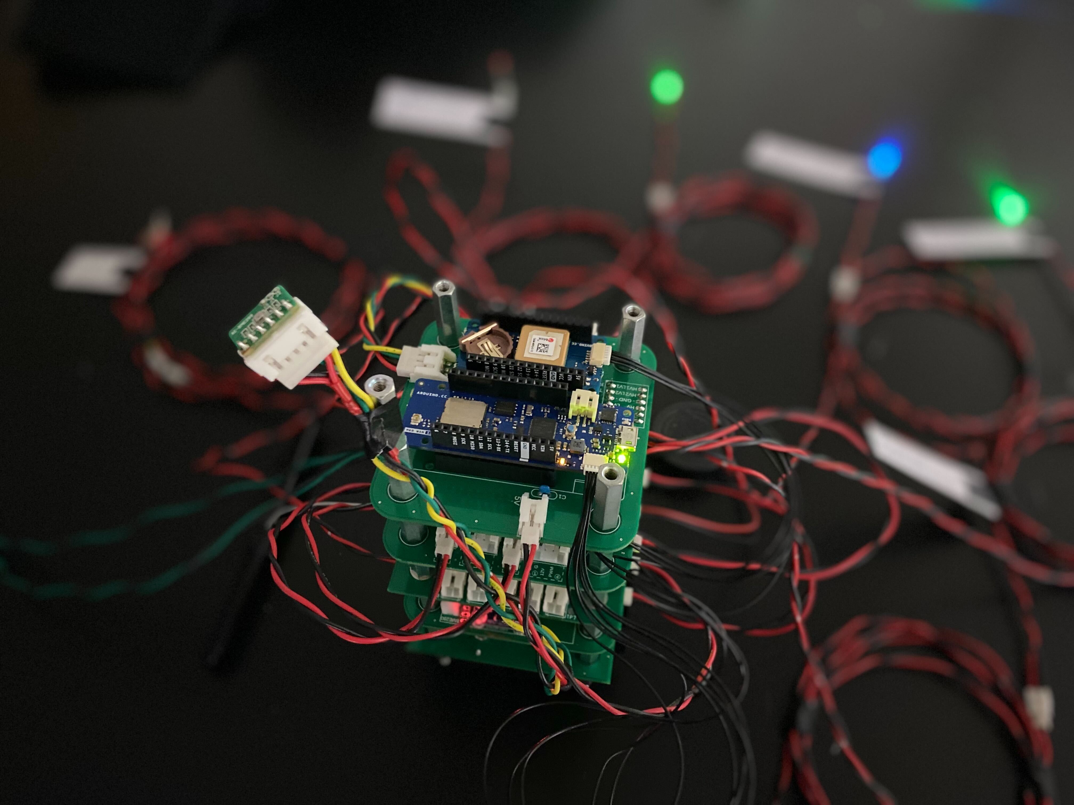
FlightComponents/Telemeter/docs/images/RGB_Avionics.jpg
