tokai-student-rocket-project/H-57-Avionics/FlightComponents/Telemeter/docs/images/TSRP_Mark.png

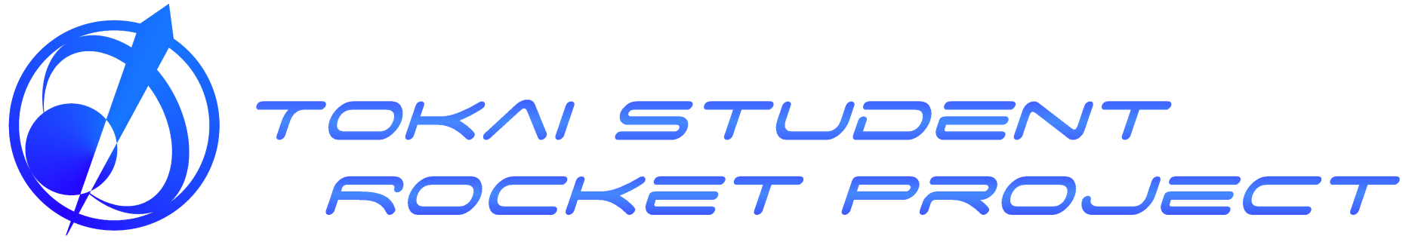
FlightComponents/Telemeter/docs/images/TSRP_Mark.png
