tokai-student-rocket-project/H-57-Avionics/FlightComponents/CommonInstrument/Hardware/Build/H-57/EM/Build-1/README.md

# 注文詳細

2022/11/30  
[PCBgogo](https://www.pcbgogo.jp/)で発注

H-57_メイン基板_EM_Build-1
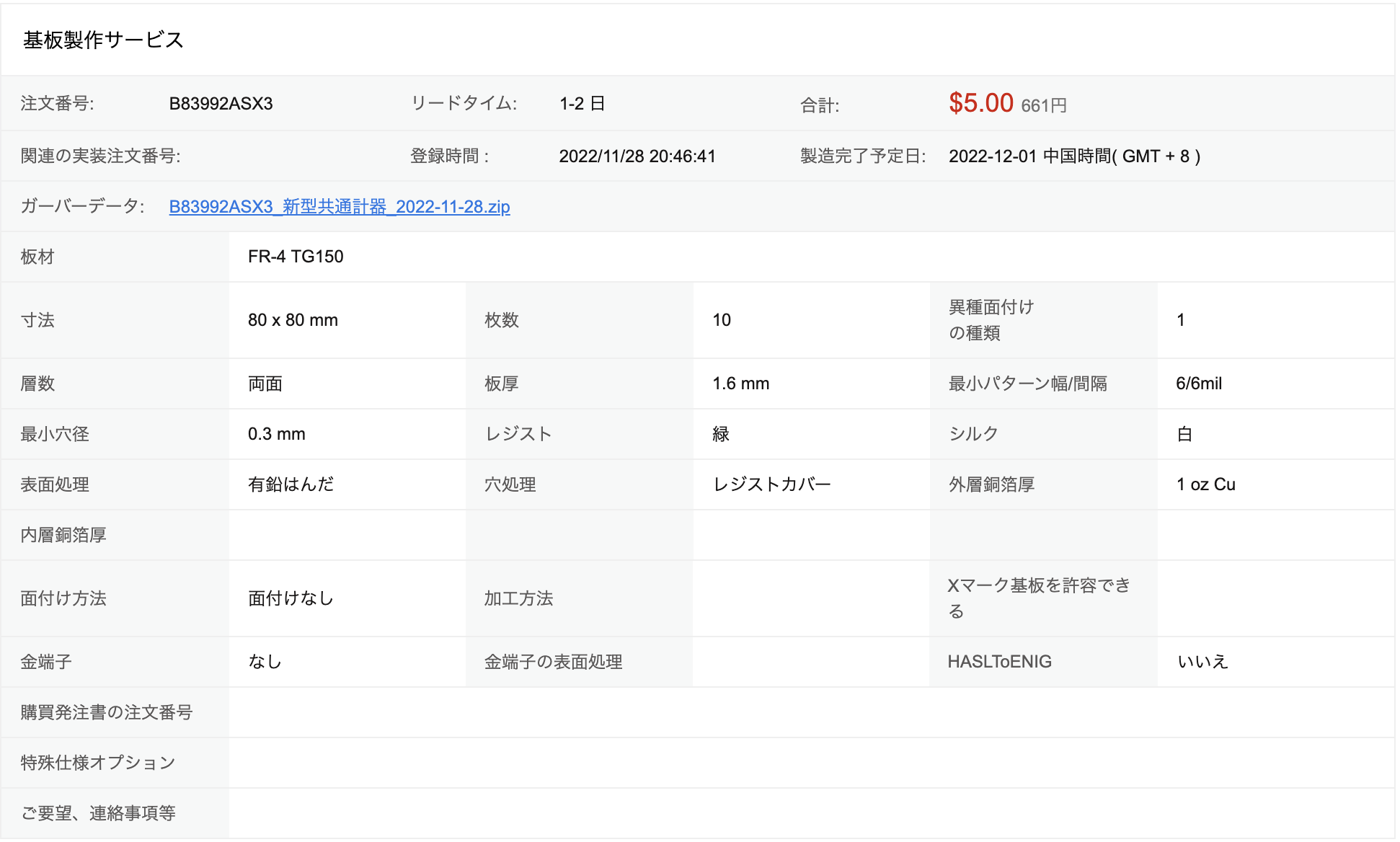
[picture p35: FlightComponents/CommonInstrument/Hardware/Build/H-57/EM/Build-1/注文詳細/H-57_メイン基板_EM_Build-1.png]
H-57_メイン基板_EM_Build-1
