tokai-student-rocket-project/H-57-Avionics/FlightComponents/CommonInstrument/Hardware/Build/H-57/EM/Build-2/README.md

# 注文詳細

2022/12/12  
[PCBgogo](https://www.pcbgogo.jp/)で発注

H-57_メモリ基板_EM_Build-2
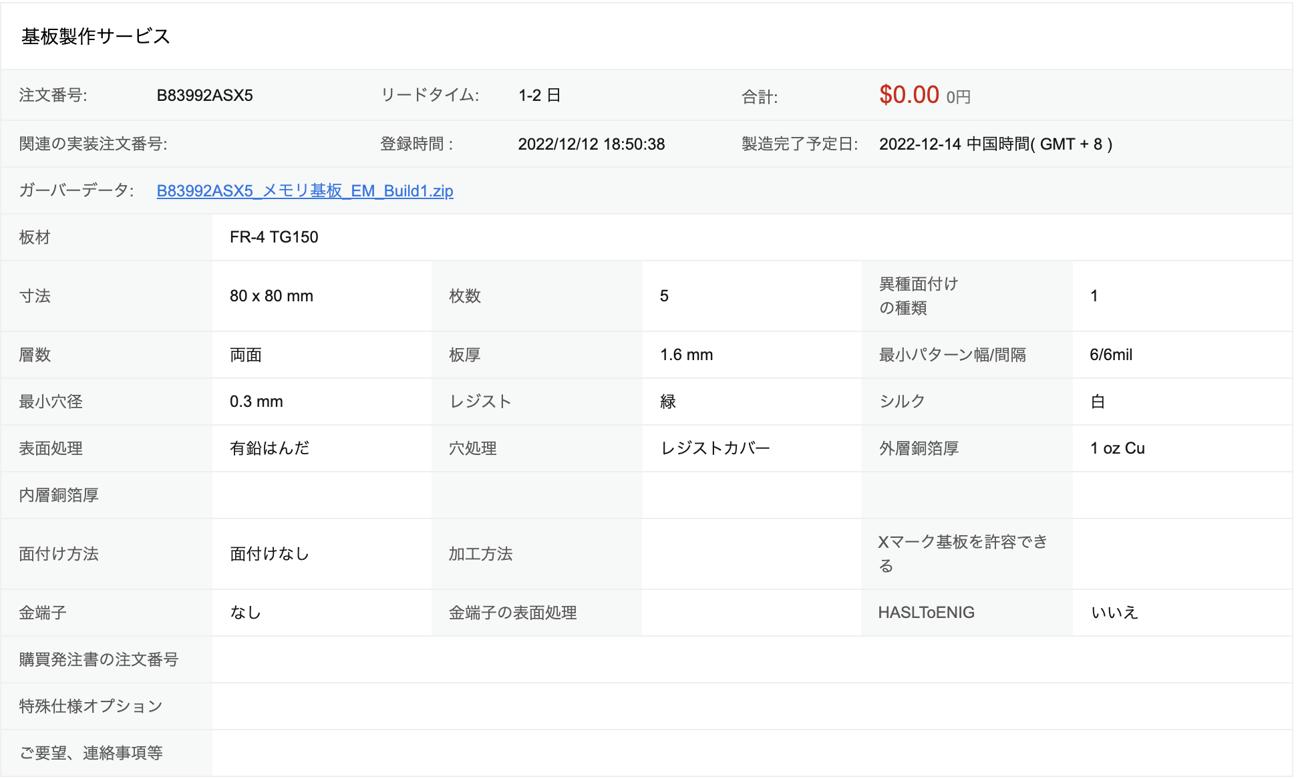
[picture p36: FlightComponents/CommonInstrument/Hardware/Build/H-57/EM/Build-2/注文詳細/H-57_メモリ基板_EM_Build-2.png]
H-57_メモリ基板_EM_Build-2


H-57_試験用電源基板_EM_Build-2
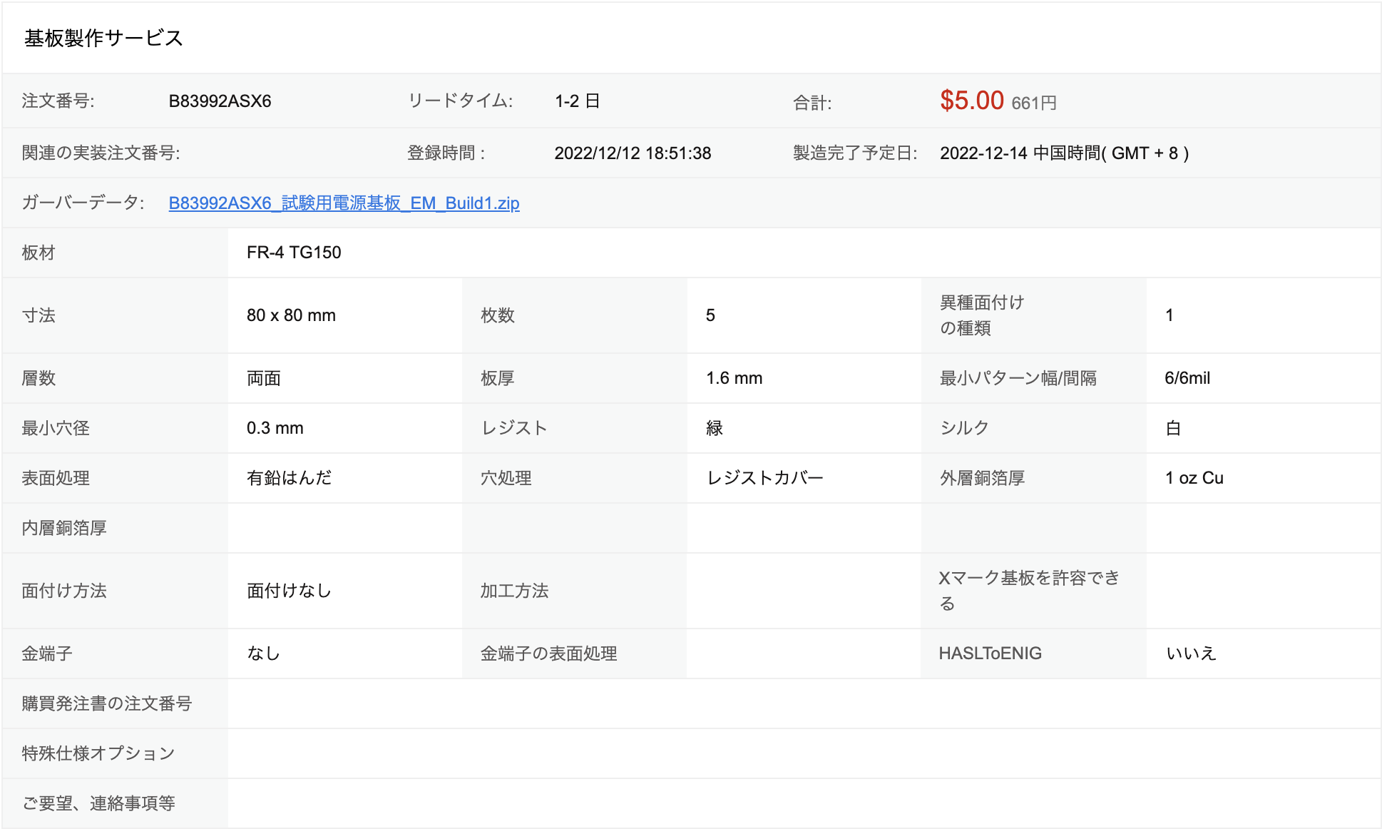
[picture p37: FlightComponents/CommonInstrument/Hardware/Build/H-57/EM/Build-2/注文詳細/H-57_試験用電源基板_EM_Build-2.png]
H-57_メモリ基板_EM_Build-2
