tokai-student-rocket-project/H-57-Avionics/FlightComponents/CommonInstrument/Hardware/Build/H-57/FM/Build-1/README.md

# 注文詳細

2022/12/12  
[PCBgogo](https://www.pcbgogo.jp/)で発注

H-57_新型共通計器_FM_Build-1
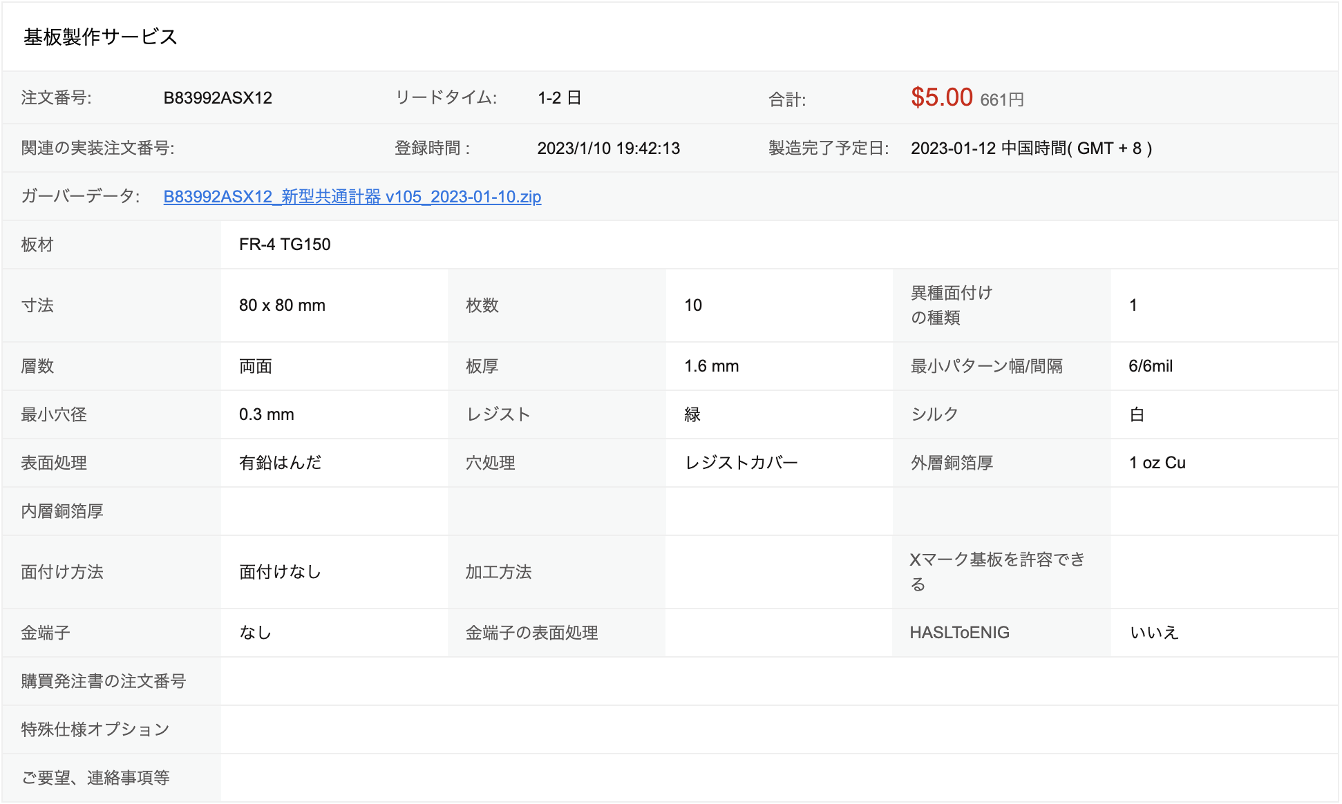
[picture p38: FlightComponents/CommonInstrument/Hardware/Build/H-57/FM/Build-1/注文詳細/H-57_新型共通計器_FM_Build-1.png]
H-57_新型共通計器_FM_Build-1
