tokai-student-rocket-project/H-57-Avionics/FlightComponents/CommonInstrument/Hardware/Build/README.md

# ガーバーデータ

## 注意

H-57_EMではメイン基板とメモリ基板が別々の基板です。H-57_FMではこれらが統合されて新型共通計器基板になっています。

試験用電源基板はDCジャックから入力電圧, DC5Vを出力する基板です。機体には搭載しないためEMしかないです。
