tokai-student-rocket-project/H-57-Avionics/FlightResult/CommonInstrument/Analysis/Integral.xlsx

Zeta | Time | Time Span | Acc X [g] | Acc Y [g] | Acc Z [g] | Gyro X [deg/s] | Gyro Y [deg/s] | Gyro Z [deg/s] | Gyro X [rad/s] | Gyro Y [rad/s] | Gyro Z [rad/s] | Norm Acc | Norm Acc X | Norm Acc Y | Norm Acc Z | F1 | F2 | F3 | J11or24 | J12or23 | J13or22 | J14or21 | J32 | J33 | Gradient hatdot 1 | Gradient hatdot 2 | Gradient hatdot 3 | Gradient hatdot 4 | Norm Gradient | Norm Gradient hatdot 1 | Norm Gradient hatdot 2 | Norm Gradient hatdot 3 | Norm Gradient hatdot 4 | Gerr X | Gerr Y | Gerr Z | Biases Gyro X | Biases Gyro Y | Biases Gyro Z | Stable Gyro X | Stable Gyro Y | Stable Gyro Z | Quaternion dot W | Quaternion dot X | Quaternion dot Y | Quaternion dot Z
0.015 | 0.1 |  | -0.57 | 0.86 | 6.68 | 1.1 | 0.61 | -16.16 | 0.01919862177 | 0.01064650844 | -0.2820452071 | 6.759208534 | -0.08432939998 | 0.1272338316 | 0.9882813893
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
