tokai-student-rocket-project/H-57-Avionics/FlightResult/CommonInstrument/Analysis/Altitude.csv

SeaLevelPressure | Pressure | Temperature | FlightTime | Pressure | Temperature | Altitude
102340 | 94980 | -4.6 | 0.1 | 102109.23 | -1 | 17.98350365
 | 97240 | -3.5 | 0.12 | 102131.72 | -1 | 16.22877068
 | 98970 | -3.4 | 0.14 | 102100.63 | -1 | 18.65462139
 | 101860 | -1.6 | 0.16 | 102118.77 | -1 | 17.23910988
 | 102090 | -0.9 | 0.19 | 102125.67 | -1 | 16.70076345
 | 102100 | -1 | 0.21 | 102135.16 | -1 | 15.96041278
 |  |  | 0.23 | 102123.95 | -1 | 16.8349559
 |  |  | 0.26 | 102144.67 | -1 | 15.21858395
 |  |  | 0.28 | 102123.95 | -1 | 16.8349559
 |  |  | 0.3 | 102123.06 | -1 | 16.90439375
 |  |  | 0.32 | 102118.77 | -1 | 17.23910988
 |  |  | 0.34 | 102129.13 | -1 | 16.43082633
 |  |  | 0.36 | 102103.22 | -1 | 18.45249862
 |  |  | 0.38 | 102118.77 | -1 | 17.23910988
 |  |  | 0.4 | 102110.99 | -1 | 17.84616692
 |  |  | 0.42 | 102103.22 | -1 | 18.45249862
 |  |  | 0.44 | 102098.88 | -0.9 | 18.79809901
 |  |  | 0.47 | 102092.85 | -0.9 | 19.26888445
 |  |  | 0.49 | 102071.24 | -1.6 | 20.90245046
 |  |  | 0.51 | 102075.55 | -1.6 | 20.56672933
 |  |  | 0.53 | 102061.76 | -1.6 | 21.64094053
 |  |  | 0.55 | 102055.7 | -1.6 | 22.11305608
 |  |  | 0.57 | 102060.02 | -1.6 | 21.77649505
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
