tokai-student-rocket-project/H-57-Avionics/FlightResult/CommonInstrument/Analysis/VerticalVelocity.csv

flight time | altitude | dt | dh | vertical velocity | average 25 | average 50 | average 100
0.1 | 9.93
0.12 | 8.08 | 0.02 | -1.85 | -92.5
0.14 | 10.64 | 0.02 | 2.56 | 128
0.16 | 9.14 | 0.02 | -1.5 | -75
0.19 | 8.57 | 0.03 | -0.57 | -19
0.21 | 7.79 | 0.02 | -0.78 | -39
0.23 | 8.72 | 0.02 | 0.93 | 46.5
0.26 | 7.01 | 0.03 | -1.71 | -57
0.28 | 8.72 | 0.02 | 1.71 | 85.5
0.3 | 8.79 | 0.02 | 0.07 | 3.5
0.32 | 9.14 | 0.02 | 0.35 | 17.5
0.34 | 8.29 | 0.02 | -0.85 | -42.5
0.36 | 10.43 | 0.02 | 2.14 | 107
0.38 | 9.14 | 0.02 | -1.29 | -64.5
0.4 | 9.79 | 0.02 | 0.65 | 32.5
0.42 | 10.43 | 0.02 | 0.64 | 32
0.44 | 10.79 | 0.02 | 0.36 | 18
0.47 | 11.28 | 0.03 | 0.49 | 16.33333333
0.49 | 13.07 | 0.02 | 1.79 | 89.5
0.51 | 12.71 | 0.02 | -0.36 | -18
0.53 | 13.85 | 0.02 | 1.14 | 57
0.55 | 14.35 | 0.02 | 0.5 | 25
0.57 | 14 | 0.02 | -0.35 | -17.5
0.59 | 14.92 | 0.02 | 0.92 | 46
0.61 | 15.64 | 0.02 | 0.72 | 36
0.63 | 15.71 | 0.02 | 0.07 | 3.5 | 12.75333333
0.65 | 16.42 | 0.02 | 0.71 | 35.5 | 17.87333333
0.68 | 17.57 | 0.03 | 1.15 | 38.33333333 | 14.28666667
0.7 | 18.92 | 0.02 | 1.35 | 67.5 | 19.98666667
0.72 | 19.14 | 0.02 | 0.22 | 11 | 21.18666667
0.75 | 19.42 | 0.03 | 0.28 | 9.333333333 | 23.12
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
