tokai-student-rocket-project/H-57-Avionics/FlightResult/CommonInstrument/Log/flight.csv

1flightTime | flightMode | stateShiranui3 | stateBuzzer | pressure | temperature | altitude | descentCount | accelerationX | accelerationY | accelerationZ | gyroX | gyroY | gyroZ | yaw | pitch | roll | voltage33 | voltage5 | voltage12
0.10 | 1 | 0 | 0 | 102109.23 | 20.49 | 9.93 | 0 | -0.57 | 0.86 | 6.68 | 1.10 | 0.61 | -16.16 | 95.47 | -4.42 | 20.06 | 3.30 | 4.86 | 12.15
0.12 | 1 | 0 | 0 | 102131.72 | 20.50 | 8.08 | 0 | -0.11 | 0.48 | 7.18 | -0.12 | 7.50 | -7.74 | 95.43 | -4.29 | 19.96 | 3.30 | 4.86 | 12.13
0.14 | 1 | 0 | 0 | 102100.63 | 20.50 | 10.64 | 0 | -1.09 | 0.57 | 7.10 | 9.33 | 7.07 | 0.85 | 95.47 | -4.15 | 19.96 | 3.29 | 4.87 | 12.17
0.16 | 1 | 0 | 0 | 102118.77 | 20.50 | 9.14 | 0 | -0.43 | 0.76 | 8.25 | 3.29 | -2.07 | 0.67 | 95.47 | -4.13 | 19.90 | 3.30 | 4.87 | 12.17
0.19 | 1 | 0 | 0 | 102125.67 | 20.51 | 8.57 | 0 | 0.04 | -0.54 | 8.17 | -2.62 | -9.51 | 2.20 | 95.47 | -4.21 | 19.77 | 3.30 | 4.87 | 12.17
0.21 | 1 | 0 | 1 | 102135.16 | 20.51 | 7.79 | 1 | -0.37 | 0.33 | 7.51 | 7.62 | -6.65 | 6.10 | 95.51 | -4.25 | 19.74 | 3.30 | 4.87 | 12.15
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
