tokai-student-rocket-project/H-57-Avionics/FlightComponents/CommonInstrument/docs/materials/SafetyReview/DescentDetectionTest.png

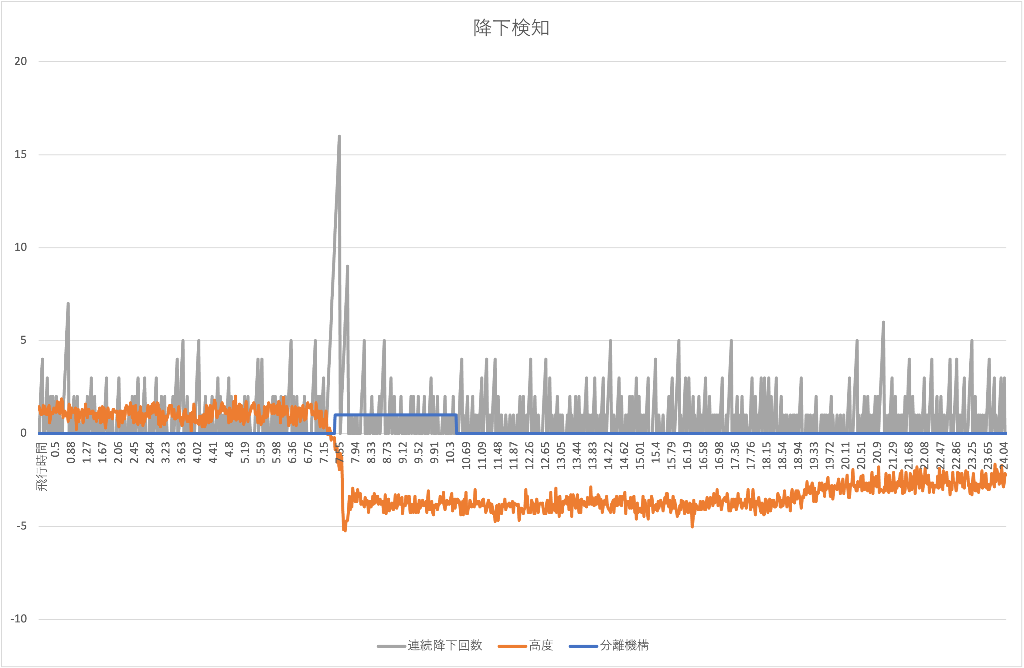
FlightComponents/CommonInstrument/docs/materials/SafetyReview/DescentDetectionTest.png
