tokai-student-rocket-project/H-57-Avionics/FlightResult/CommonInstrument/Images/ApogeeDetection.png

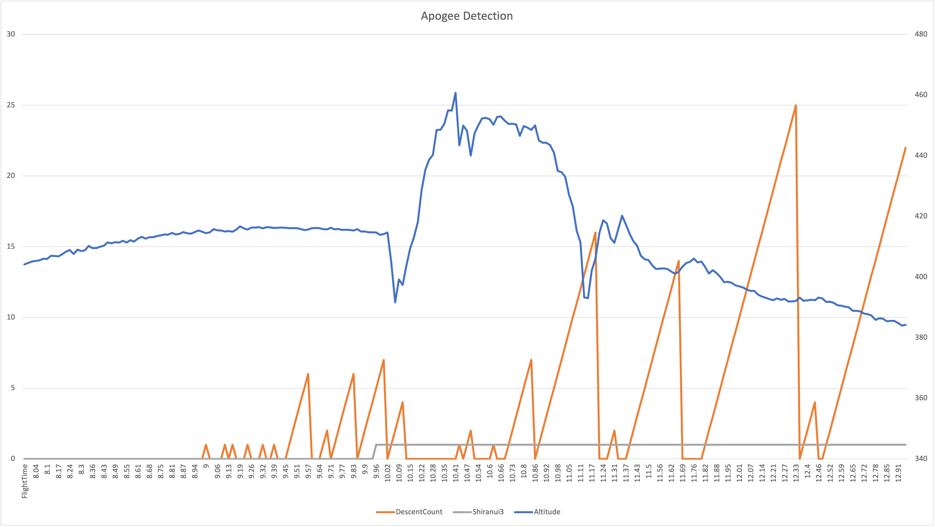
FlightResult/CommonInstrument/Images/ApogeeDetection.png
