tokai-student-rocket-project/H-57-Avionics/FlightResult/CommonInstrument/Images/Board/After/Battery/B4.jpg

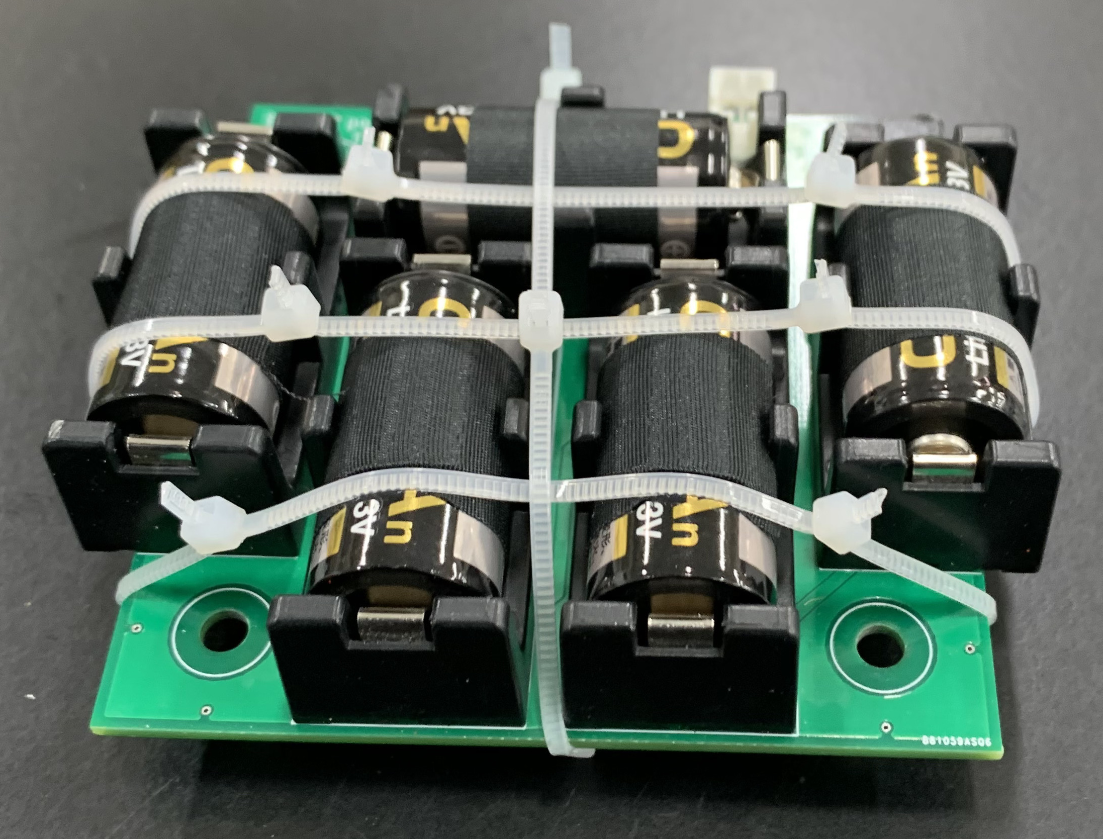
FlightResult/CommonInstrument/Images/Board/After/Battery/B4.jpg
