tokai-student-rocket-project/H-57-Avionics/FlightResult/CommonInstrument/Images/Board/After/Power/P2.jpg

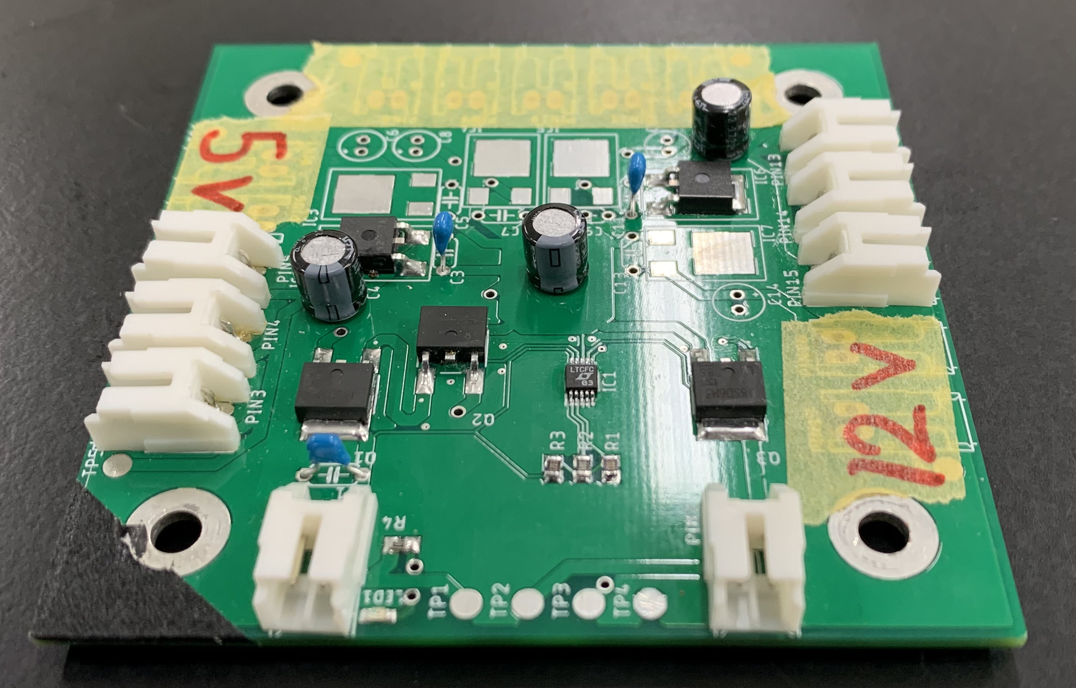
FlightResult/CommonInstrument/Images/Board/After/Power/P2.jpg
