tokai-student-rocket-project/H-57-Avionics/FlightResult/CommonInstrument/Images/Board/After/Power/P3.jpg

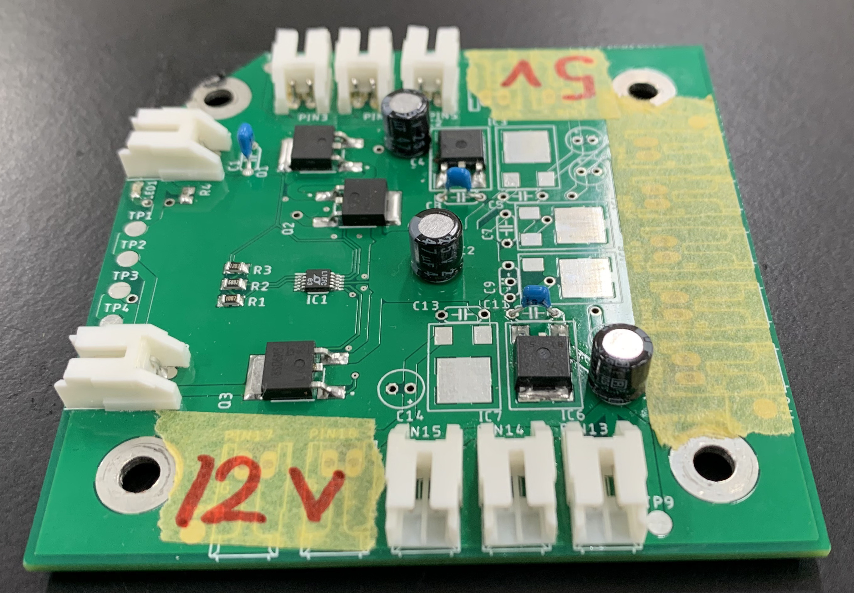
FlightResult/CommonInstrument/Images/Board/After/Power/P3.jpg
