tokai-student-rocket-project/H-57-Avionics/FlightResult/CommonInstrument/Images/Board/After/Power/P6.jpg

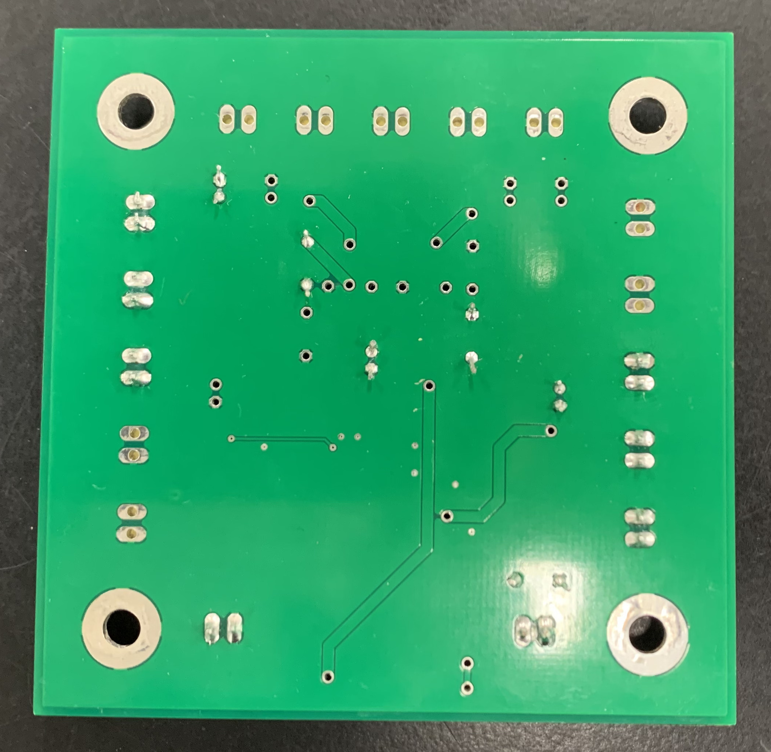
FlightResult/CommonInstrument/Images/Board/After/Power/P6.jpg
