tokai-student-rocket-project/H-57-Avionics/FlightResult/CommonInstrument/Images/Board/After/Telemeter/T2.jpg

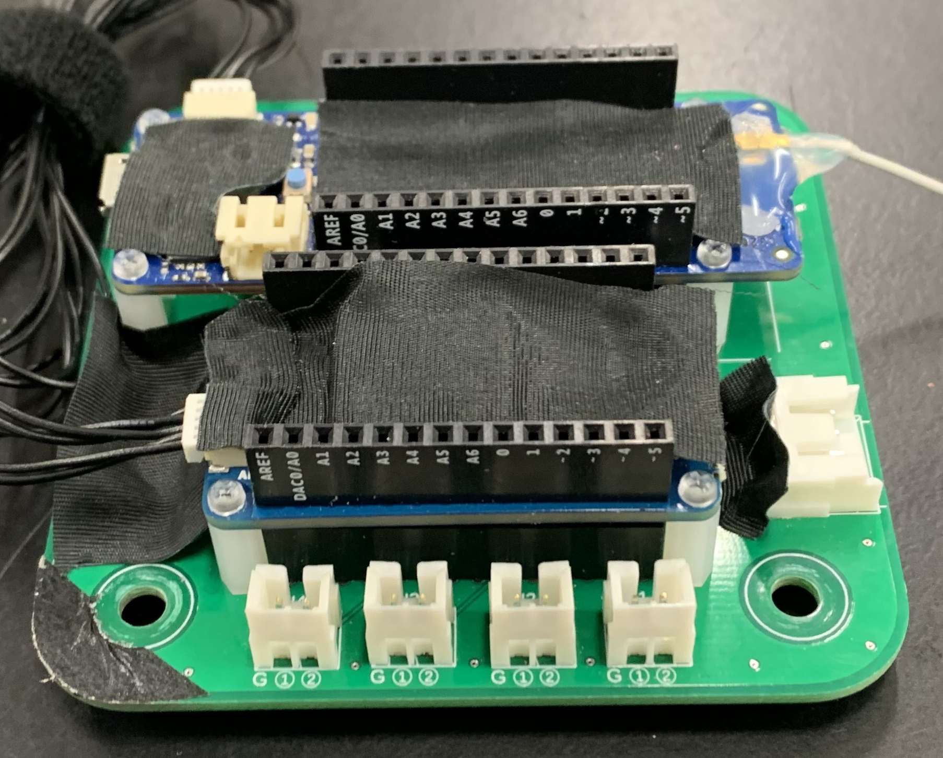
FlightResult/CommonInstrument/Images/Board/After/Telemeter/T2.jpg
