tokai-student-rocket-project/H-57-Avionics/FlightResult/CommonInstrument/Images/Board/After/Telemeter/T3.jpg

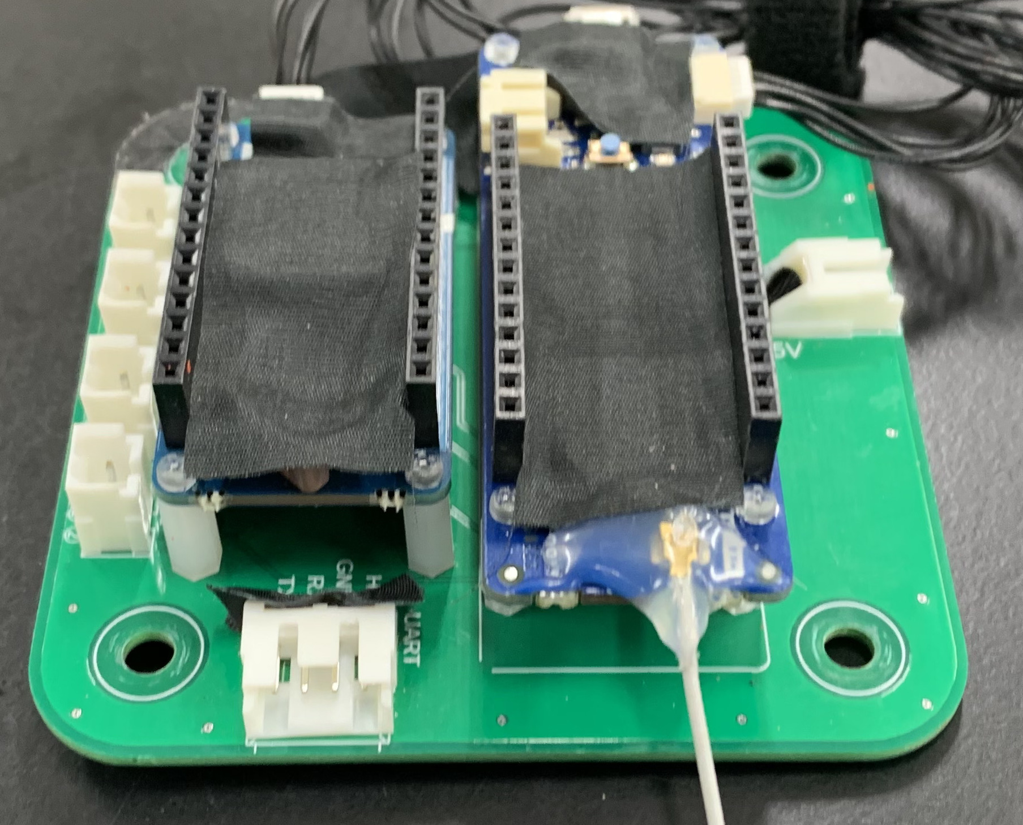
FlightResult/CommonInstrument/Images/Board/After/Telemeter/T3.jpg
