tokai-student-rocket-project/H-57-Avionics/FlightResult/CommonInstrument/Images/Board/After/ValveControler/V5.jpg

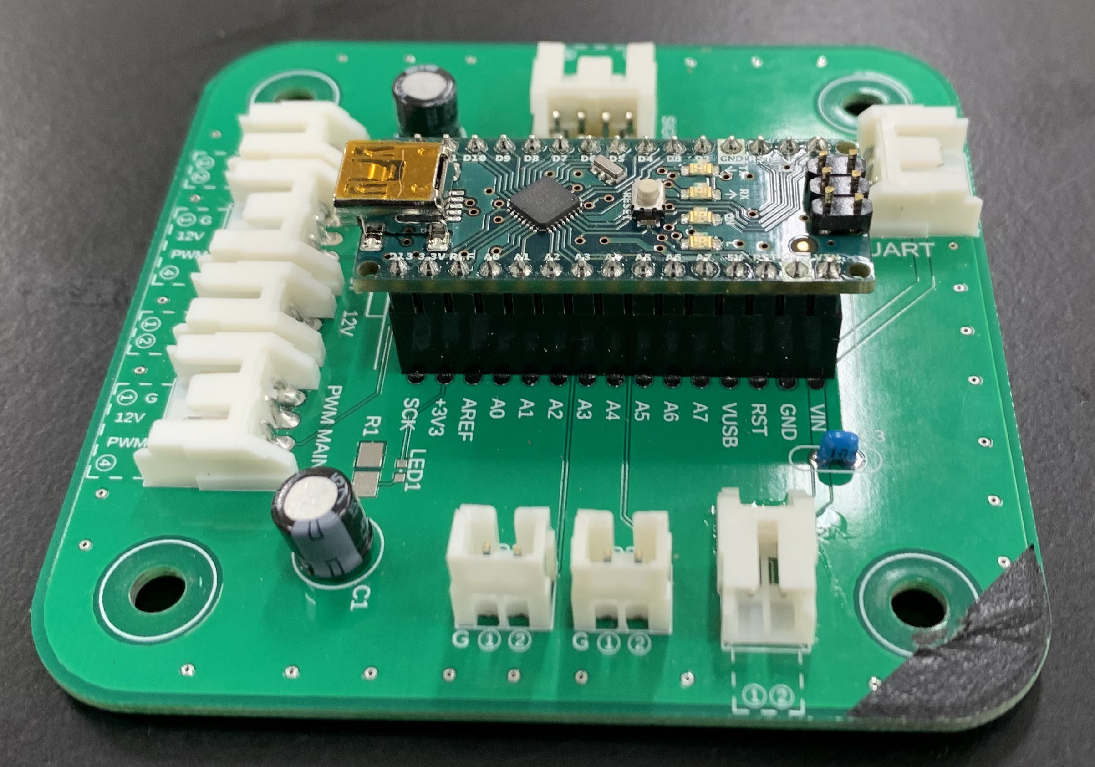
FlightResult/CommonInstrument/Images/Board/After/ValveControler/V5.jpg
