tokai-student-rocket-project/H-57-Avionics/FlightResult/CommonInstrument/Images/Board/After/ValveControler/V6.jpg

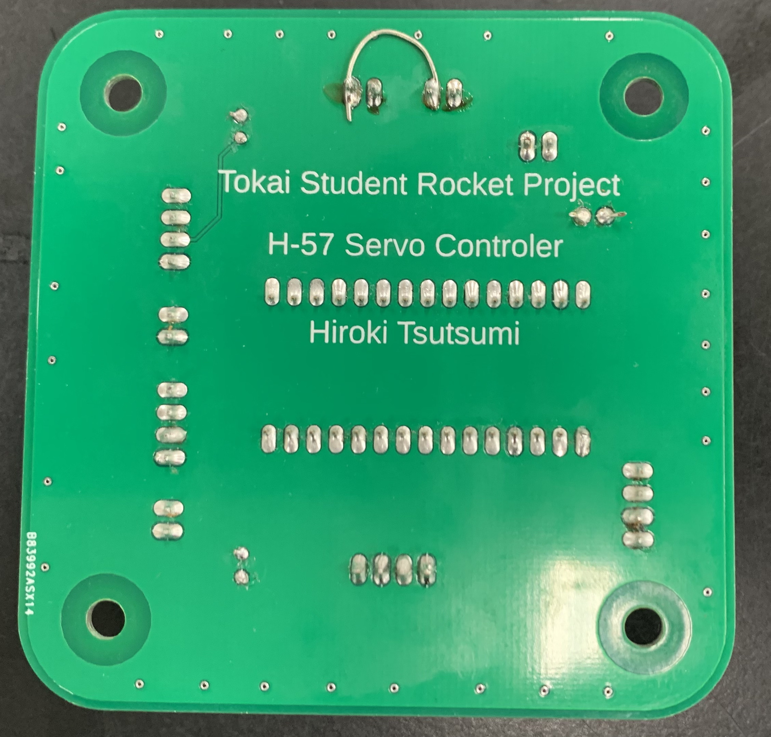
FlightResult/CommonInstrument/Images/Board/After/ValveControler/V6.jpg
