tokai-student-rocket-project/H-57-Avionics/FlightResult/CommonInstrument/Images/Board/Before/Battery/B2.jpg

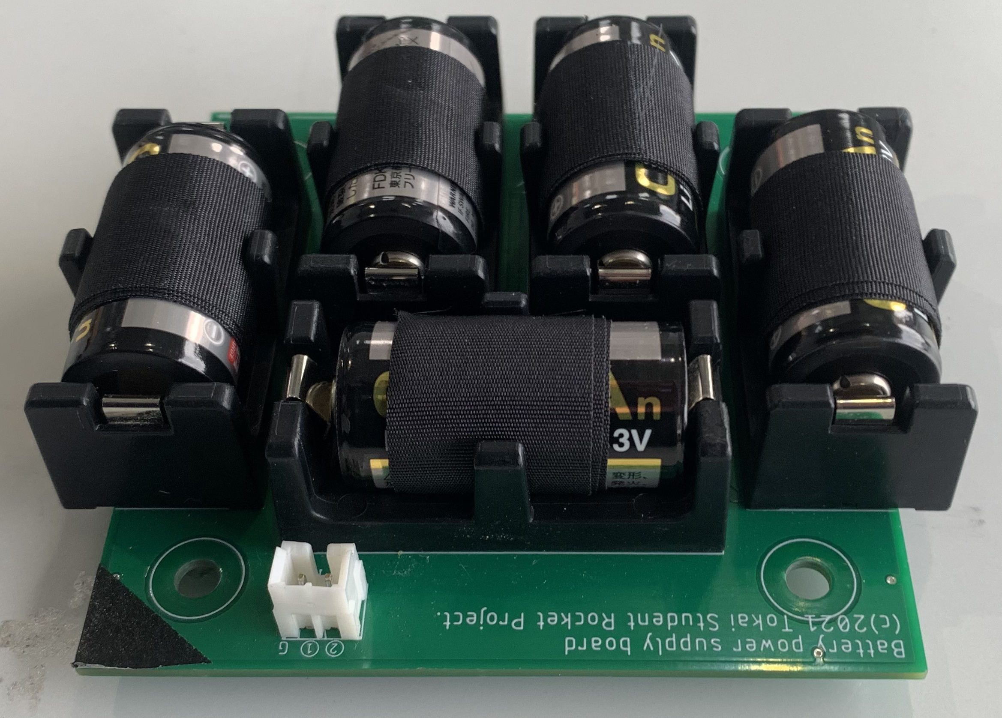
FlightResult/CommonInstrument/Images/Board/Before/Battery/B2.jpg
