tokai-student-rocket-project/H-57-Avionics/FlightResult/CommonInstrument/Images/Board/Before/Battery/B5.jpg

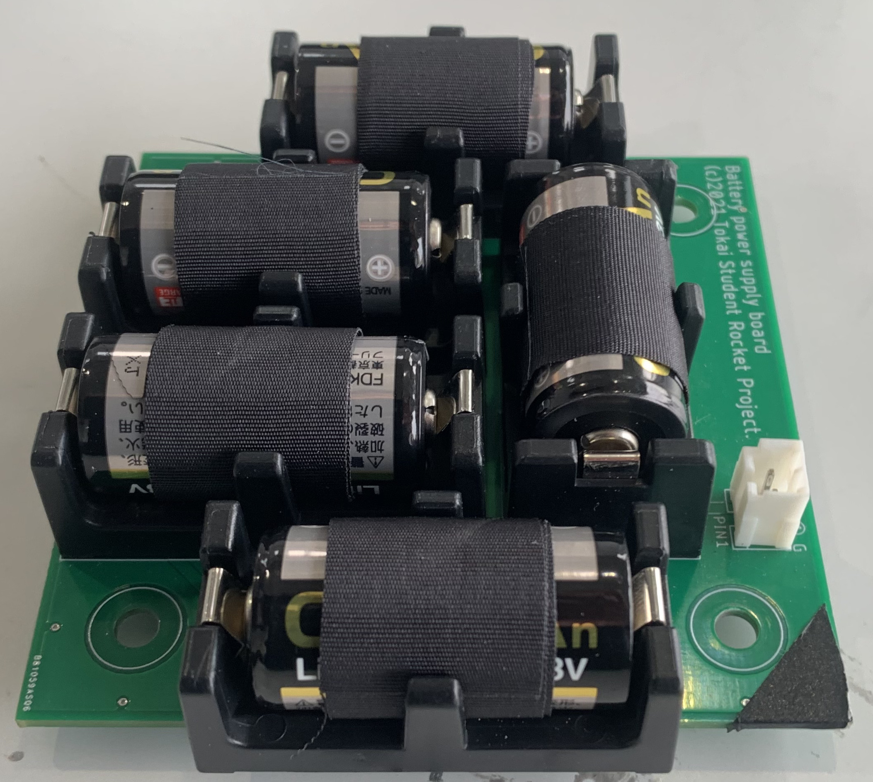
FlightResult/CommonInstrument/Images/Board/Before/Battery/B5.jpg
