tokai-student-rocket-project/H-57-Avionics/FlightResult/CommonInstrument/Images/Board/Before/CommonInstruments/C3.jpg

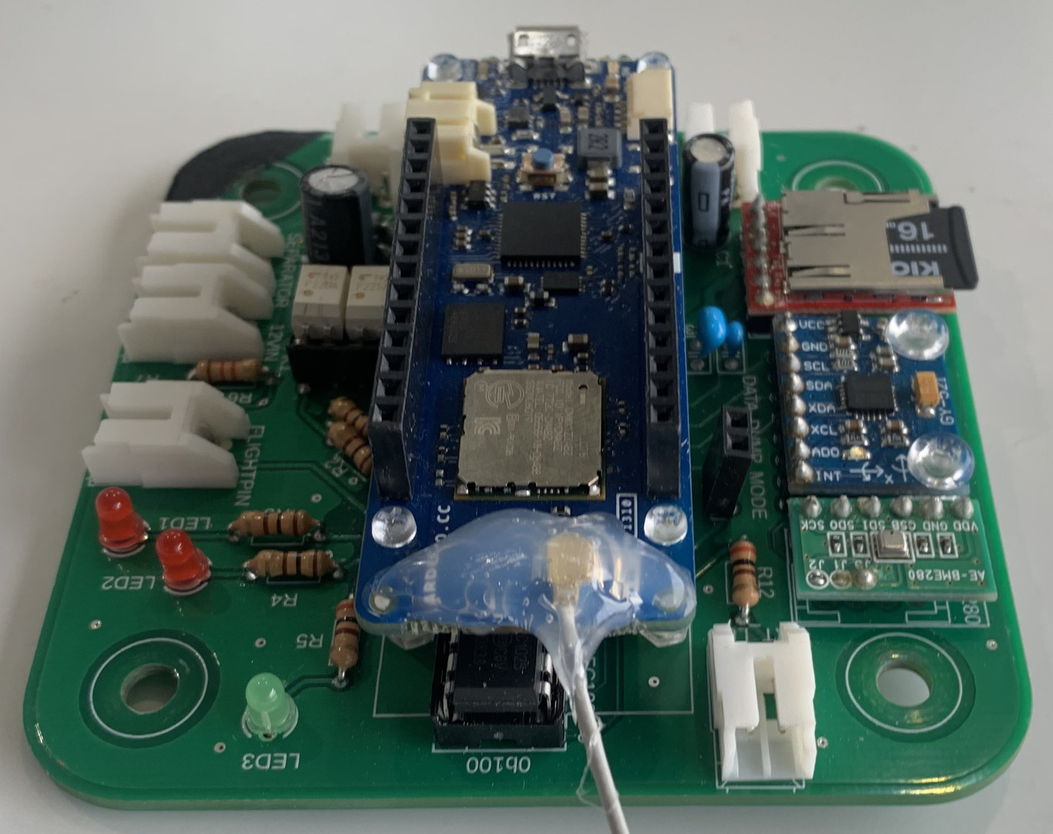
FlightResult/CommonInstrument/Images/Board/Before/CommonInstruments/C3.jpg
