tokai-student-rocket-project/H-57-Avionics/FlightResult/CommonInstrument/Images/Board/Before/Power/P4.jpg

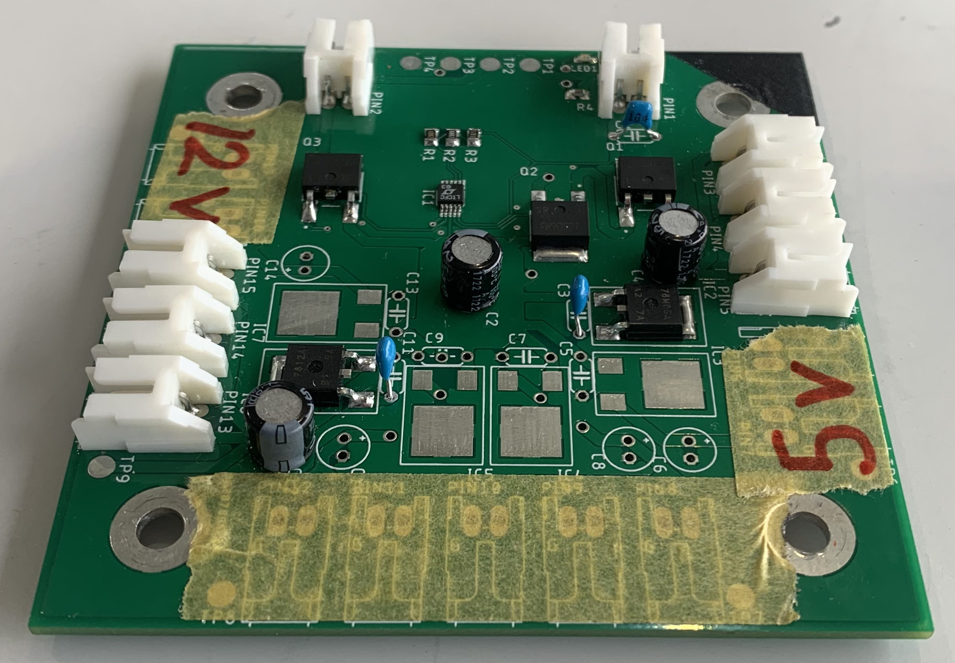
FlightResult/CommonInstrument/Images/Board/Before/Power/P4.jpg
