tokai-student-rocket-project/H-57-Avionics/FlightResult/CommonInstrument/Images/Board/Before/ValveControler/V2.jpg

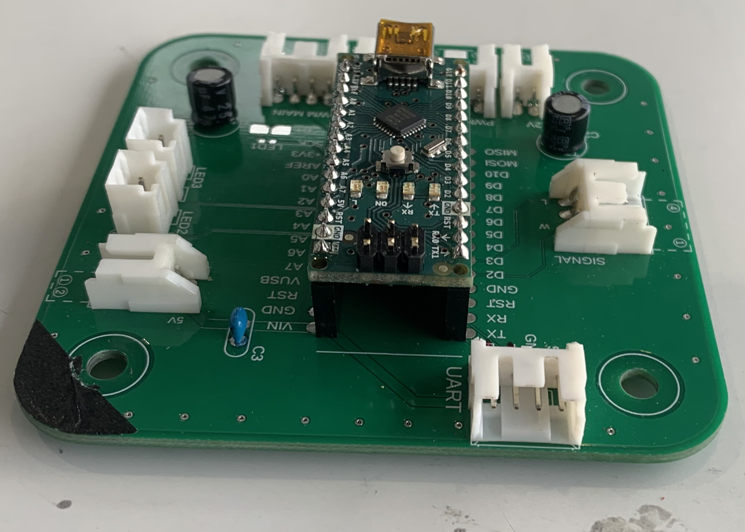
FlightResult/CommonInstrument/Images/Board/Before/ValveControler/V2.jpg
