tokai-student-rocket-project/H-57-Avionics/FlightComponents/Telemeter/Hardware/ValveContoroller.pdf

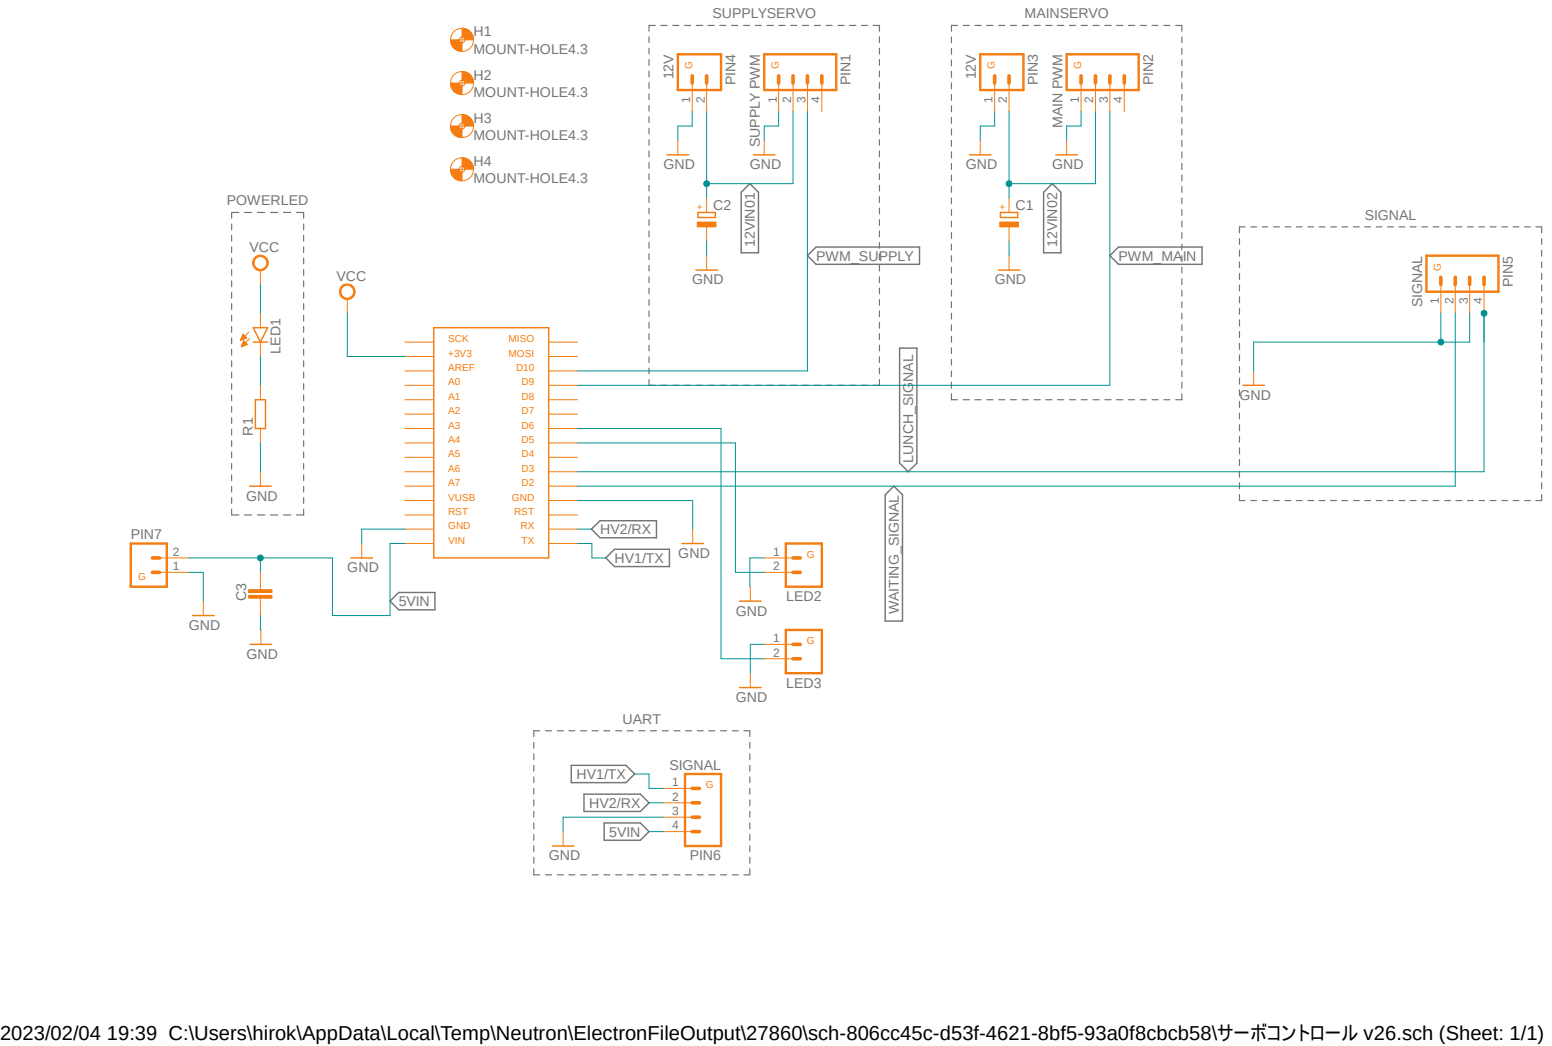
[picture p147: page 1]

2023/02/04 19:39 C:\Users\hirok\AppData\Local\Temp\Neutron\ElectronFileOutput\27860\sch-806cc45c-d53f-4621-8bf5-93a0f8cbcb58\サーボコントロール v26.sch (Sheet: 1/1)
