tokai-student-rocket-project/H-57-Avionics/FlightComponents/Telemeter/ValveContoroler/ValveContoroler.ino

/*
  Auther    Hiroki TSUTSUMI(1CES2116)
  Rocket    H-57
  MCU       Series:Arduino
  MCU       ATMEGA328P

  バルブ位置を制御し、テレメトリーモジュールに送信する機能を持っています。
*/

#include "VarSpeedServo.h"
#include <ArduinoJson.h>

constexpr int POSITION_CHANGING_THRESHOLD = 10;

int LCount = 0;
int WCount = 0;

// 1: Waiting, 2: Launch
int Position = 1;

// Servo設定
VarSpeedServo Mainservo;
VarSpeedServo Supplyservo;
// int MainServoPin = 5; // Uno
int MainServoPin = 9; // Nano
// int SupplyServoPin = 6; // Uno
int SupplyServoPin = 10; // Nano
float Supplyservo_deg;
float Mainservo_deg;

void setup()
{
    // Serial.begin(115200);
    //  while (!Serial)
    //      continue;
    Serial.begin(9600);
    // Serial.begin(115200);

    Mainservo.attach(MainServoPin);
    Mainservo.write(20, 30, true); // 不感体に近い為初期値を20度ずらした。 0 -=> 20, 140 -=> 160
    Supplyservo.attach(SupplyServoPin);
    Supplyservo.write(20, 30, true); // 不感体に近い為初期値を20度ずらした。 0 -=> 20, 60 -=> 80

    pinMode(2, INPUT_PULLUP); // WAITING <=- Arduino UNO　//LAUNCH <=- Arduino NANO　//ただの設計ミス。ソフトウェアで解決可能なのでUNO,NANOで切り替える
    pinMode(3, INPUT_PULLUP); // LUNCH <=- ArduinoUNO //WAITING <=- Arduino NANO

    // pinMode(3, INPUT_PULLUP); // WAITING <=- Arduino UNO　//LAUNCH <=- Arduino NANO　//ただの設計ミス。ソフトウェアで解決可能なのでUNO,NANOで切り替える
    // pinMode(2, INPUT_PULLUP); // LUNCH <=- ArduinoUNO //WAITING <=- Arduino NANO

    // pinMode(LED_BUILTIN, OUTPUT); //UNO
    pinMode(5, OUTPUT); // NANO
    pinMode(6, OUTPUT); // NANO

    digitalWrite(6, HIGH); // NANO
    digitalWrite(5, LOW);  // NANO

    delay(1000);
}

void loop()
{
    // WaitingポジションかつLaunch信号がHIGHならLCountを加算する。それ以外ならLCountを0にリセットする
    // if (Position == 1 && digitalRead(2) == LOW) //NANO
    if (Position == 1 && digitalRead(3) == LOW) // UNO
    {
        LCount++;
    }
    else
    {
        LCount = 0;
    }

    // LCountが閾値以上になればLaunchポジションに変更する
    if (LCount >= POSITION_CHANGING_THRESHOLD)
    {
        LCount = 0;

        L_Position();
        Position = 2;
        delay(300);
    }

    // 以下、WaitingとLaunchが逆になったバージョン
    // if (Position == 2 && digitalRead(3) == LOW) //NANO
    if (Position == 2 && digitalRead(2) == LOW) // UNO
    {
        WCount++;
    }
    else
    {
        WCount = 0;
    }

    if (WCount >= POSITION_CHANGING_THRESHOLD)
    {
        WCount = 0;

        W_Position();
        Position = 1;
        delay(300);
    }

    // Arduinojson
    StaticJsonDocument<64> servoPacket;
    servoPacket["mainservoDeg"] = Mainservo_deg;
    servoPacket["supplyservoDeg"] = Supplyservo_deg;

    Serial.println();
    serializeJson(servoPacket, Serial);

    // Arduino IDE シリアルプロッタでのデバック用
    //  Serial.print(WCount);
    //  Serial.print(",");
    //  Serial.println(LCount);

    // delayMicroseconds(100);
    delay(2); // 250Hz
    // delay(10); // 100Hz
}
void L_Position()
{
    // 2023/1/21 フローテック -=> Sweagelock にバルブ変更
    // SERVO.write(deg, speed, true)
    Supplyservo.write(80, 60, true);        // UNO, NANO // Supply Valve CLOSE //0:MAX Speed 1-255:Slower-Faster
    // FILLバルブ：80度で閉

    delay(200);                             //処理落ち防止用

    // SERVO.write(deg, speed, true)
    Mainservo.write(57, 50, true);          // UNO, NANO // Main Valve OPEN //0:MAX Speed 1-255:Slower-Faster

    // digitalWrite(LED_BUILTIN, HIGH);     // UNO //状態確認用
    digitalWrite(5, HIGH);                  // NANO //Valve OPEN LED HIGH
    digitalWrite(6, LOW);                   // NANO //Valve CLOSE LED LOW

    Supplyservo_deg = Supplyservo.read();   //Supple Servo 角度の読み出し
    Mainservo_deg = Mainservo.read();       //Main Serovo 角度読み出し

    // メモ BEGIN
    //  2022/12/21
    //  コールドフロー試験
    //  Mainservo.write(140, 30, true); 角度140°、速度30にて成功
    //  成功を踏まえて...速度を早くするべきかどうか検討する必要あり。
    //
    //  2022/12/23
    //  燃焼実験
    //  Mainservo.write(140,50, true);角度140°、速度50で実験
    //  点火成功！
    //
    //  2023/1/11
    //  コールドフロー試験
    //  Supplyservo.write(60, 60, true);
    //  Supplyservo_deg = Supplyservo.read();
    //  delay(10);
    //  Mainservo.write(140, 50, true);
    //  Mainservo_deg = Mainservo.read();
    //  digitalWrite(LED_BUILTIN, HIGH);
    //  上記の動作でコールドフロー試験を成功させることが出来た。やったね！
    //
    //  Swagelockバルブでのコールドフロー試験
    //  Supplyservo.write(80, 255, true); // SupplyServo CLOSE
    //  delay(100);
    //  Mainservo.write(57, 40, true); // UNO //NANO
    // メモ END
}

void W_Position()
{
    // SERVO.write(deg, speed, true)
    Supplyservo.write(20, 30, true);        // Supply Valve OPEN

    delay(10);                              //処理落ち防止用　
    
    // SERVO.write(deg, speed, true)
    Mainservo.write(20, 30, true);          // Main Valve CLOSE

    // digitalWrite(LED_BUILTIN, LOW);      // UNO //状態確認用
    digitalWrite(5, LOW);                   // NANO //Valve OPEN LED HIGH
    digitalWrite(6, HIGH);                  // NANO //Valve CLOSE LED LOW

    Supplyservo_deg = Supplyservo.read();   //Supple Servo 角度の読み出し
    Mainservo_deg = Mainservo.read();       //Main Servo 角度読み出し
}

/*
                                      .[
                                   .dMM@
                   ...&gNMMMMNNgJ+MMMMMN
               ..MMMMH"""7??77""MMMMMMMM;
            .JMMMMMMMMMMMMNg,. .MMMMMMMMN,
          .MMMWMMMMMMMMMMMMMMMNMMMMMMMM"WMN,
        .dM#^JM#"         ?TMMMMMMMMMM^  .WMN,
       .MMt JM^              .MMMMMMM'     ,MMb
      .MM! .@               .MMMMMMMMb       UMN.
     .M#`  d`               dMMMMMMMMMN,      UMN
    .MM!   F               .MMMMM#`,MMMM,      HMb
    MMF    \    ...       .MMMMM#`  .MMMM,     ,MM.
   .MM`    i.MMMMMMMMNJ.  dMMMM#     .MMMN.     MM]
   -M#   .dMMMMMMMMMMMMMN.MMMM@       ,MMMb     JM@
   (M#  .MMMMMMMMMMMMMMM# TMM@         dMMM;    (M#
   -M# .MMMMMMMMMMMMMMMM'  WF          .MMMb    JMF
   .MM.dMMMMMMMMMMMMMMMF   .            MMMN    MM]
    dMbMMMMMMMMMMMMMMM@   .#            MMMN   .MM
    .MMdMMMMMMMMMMMMMM!  .MF            MMM#  .MMt
     -MMMMMMMMMMMMMMMF  .M@            .MMMF .MMF
      (MMMMMMMMMMMMM@  .MD            .MMMM`.MMF
       ,MMNTMMMMMMMM! ,"             .MMMM\.MM3
         TMMa._7"""QN"(.           ..MMMMQMM@`
           TMMN,  .M3   74J......(MMMMMMMM@!
             ?WMMNML.       ?"""HHMNMMM#"
                (MHMMMMNggg&ggNMMMMM9^
                .^   -?""""""""7!
*/
