tokai-student-rocket-project/H-57-Avionics/FlightComponents/CommonInstrument/FlightComputer/Telemeter.h

#ifndef TELEMETER_H_
#define TELEMETER_H_

class Telemeter
{
private:
  uint8_t statusLabel = 0x01;
  uint8_t flightDataLabel = 0x02;
  uint8_t configLabel = 0x03;
  uint8_t eventLabel = 0x04;

  uint8_t _stack[256];
  uint32_t _stackOffset;

  uint32_t _event_count;

  void stackPacket(const uint8_t* data, const size_t size);

public:
  void sendStackedData();

  void stackStatus(
    uint8_t flightMode,
    bool flightPinState,
    bool shiranui3State,
    bool buzzerState,
    float v33State,
    float v5State,
    float v12State
  );

  void stackFlightData(
    float flightTime,
    float altitude,
    float acceleration,
    float yaw,
    float pitch,
    float roll
  );

  void stackConfig(
    float separationAltitude,
    float basePressure,
    float burnTime,
    float separationProtectionTime,
    float forceSeparationTime,
    float landingTime
  );

  void stackEvent(
    uint8_t event,
    float flightTime
  );
};

#endif
