tokai-student-rocket-project/H-57-Avionics/ExperimentalComponents/Transmission/Sender/Sender.ino

#include <SPI.h>
#include <LoRa.h>

int counter = 0;

void setup() {
  Serial.begin(9600);
  Serial.println("LoRa Sender");

  if (!LoRa.begin(923E6)) {
    Serial.println("Starting LoRa failed!");
    while (1);
  }
}

void loop() {
  Serial.print("Sending packet: ");
  Serial.println(counter);

  // send packet
  LoRa.beginPacket();
  LoRa.print("hello ");
  LoRa.print(counter);
  LoRa.endPacket();

  counter++;

  delay(1000);
}
