tokai-student-rocket-project/H-57-Avionics/ExperimentalComponents/SixAxisSensor/SixAxisSensor.ino

#include <Wire.h>
#include <MultiUART.h>
#include <Arduino_JSON.h>
#include <MPU6050_6Axis_MotionApps20.h>

MPU6050 SixAxisSensor;

MultiUART PC(Serial);
MultiUART SD(2, 3);

JSONVar Data;

int16_t Ax, Ay, Az;
int16_t Gx, Gy, Gz;

float AccelScaleFactor = 2048.0;
float GyroScaleFactor = 16.4;

void setup()
{
  Wire.begin();
  PC.begin(9600);
  SD.begin(9600);

  while (!SD)
    ;

  SixAxisSensor.initialize();

  SixAxisSensor.setFullScaleAccelRange(MPU6050_ACCEL_FS_16);
  SixAxisSensor.setFullScaleGyroRange(MPU6050_GYRO_FS_2000);
}

void loop()
{
  SixAxisSensor.getMotion6(&Ax, &Ay, &Az, &Gx, &Gy, &Gz);

  Data["Time"] = millis();
  Data["AccX"] = Ax / AccelScaleFactor;
  Data["AccY"] = Ay / AccelScaleFactor;
  Data["AccZ"] = Az / AccelScaleFactor;
  Data["GyroX"] = Gx / GyroScaleFactor;
  Data["GyroY"] = Gy / GyroScaleFactor;
  Data["GyroZ"] = Gz / GyroScaleFactor;

  SD.println(Data);

  delay(10);
}
