tokai-student-rocket-project/H-57-Avionics/ExperimentalComponents/PressureSensor/PressureSensorl.ino

#include <Wire.h>
#include "LPS22HB.h"

// センサのインスタンス
LPS22HB PressureSensor;

void setup()
{
  Wire.begin();
  Serial.begin(9600);

  PressureSensor.initialize();
}

void loop()
{
  Serial.println(PressureSensor.getTemperature());
}
