tokai-student-rocket-project/H-57-Avionics/(commit log)

2022-08-26 LPS22HBのラッパーライブラリを追加
2022-08-26 高度算出用のライブラリを追加
2022-08-26 .gitignoreを追加
2022-08-26 FDCを追加
2022-08-26 READMEを追加
2022-08-26 燃焼実験用のコンポーネントを追加
2022-08-27 FMCを追加
2022-08-27 FDC, FMC間の通信にCOBSを使用
2022-08-28 MultiUARTを使うように変更
2022-08-28 フライトデータの発行方法をsendからpublishへ変更
2022-08-28 フライトデータをハードウェアシリアルに流すコールバックを追加
2022-08-29 READMEにフライトデータの形式を記載
2022-08-29 フライトデータを高度のみに変更
2022-08-29 ハードウェアシリアルにMultiUARTを使うように変更
2022-08-29 READMEに参考文献を追加
2022-08-29 コールドフローのログを追加
2022-08-29 6軸センサのテストを追加
2022-08-29 ログの場所を移動
2022-08-29 ログのフォーマットをJSONに変更
2022-08-31 移動平均のライブラリを追加
2022-08-31 移動平均法を指数平滑に変更
2022-08-31 グローバル変数を名前空間の中に入れた
2022-09-01 頂点検出のライブラリを追加
2022-09-02 MovingAverageとDescentDetectorを統合
2022-09-03 フライトピンを実装
2022-09-03 FMCの命名規則を統一
2022-09-03 名言を追加
2022-09-03 命名規則を統一
2022-09-03 変数名を修正
2022-09-06 分離を実装
2022-09-07 setup関数内でresetを使うように修正
2022-09-07 フライトピンの抽象化クラスを追加
2022-09-07 不知火の抽象化クラスを追加
2022-09-07 LEDの抽象化クラスを追加
2022-09-07 CのenumからC++のenum classに変更
2022-09-07 燃焼中に分離しないように変更
2022-09-07 フライトデータに気圧を追加しました
2022-09-10 READMEに概要を追加
2022-09-14 アップリンクを追加
2022-09-14 FDRを追加しました。
2022-09-19 FMCにFDC, FDRを統合
2022-09-19 LEDの切り替えをまとめました
2022-09-19 フライトモードの処理を分離
2022-09-19 namespaceにインデントをつけました
2022-09-22 ブザーを追加
2022-09-26 周波数を920MHzから923MHzに変更
2022-09-26 コマンドを追加
2022-09-26 FMCを最小構成に変更
2022-09-29 アップリンクを実装
2022-09-30 LEDクラスを削除
2022-10-11 伝送試験用コードを追加
2022-10-13 分離のログを追加
2022-10-13 loopが100Hzになるように変更
2022-10-14 loopを100Hzに修正
2022-10-17 loopの周期を可変に変更
2022-10-17 気圧取得の前に気温取得をするように変更
2022-10-17 ロギングの通信速度を115200に変更
2022-10-24 ログに加速度, 各速度を追加
2022-10-24 コマンドを実装
2022-11-04 分離処理を関数に切り出しました
2022-11-07 不知火3とブザーを分離
2022-11-10 コマンドをjsonに変更
2022-11-10 フライトピンの抽象化クラスを実装
2022-11-10 コマンドをjsonで実装
2022-11-11 デバイスの抽象化クラスを実装
2022-11-14 コマンド処理中にビルトインLEDを点灯するように変更
2022-11-14 イベントをjsonで実装
2022-11-14 ダウンリンクをクリアするように変更
2022-11-14 共通計器のフォルダを変更
2022-11-14 フォルダ構成を変更
2022-11-14 地上ソフトウェアを構成
2022-11-14 npmを初期化
2022-11-15 サンプルコードを削除
2022-11-15 シリアルモニタを実装
2022-11-16 シリアルモニターを実装
2022-11-16 状態のダウンリンク実装
2022-11-17 コンフィグのデザインを実装
2022-11-17 コマンドのデザインを追加
2022-11-17 ヘッダーのデザインを実装
2022-11-17 ワイヤーフレームをH-57に変更
2022-11-17 高度, 速度の表示を実装
2022-11-17 flightDataUpdatedのメモリーリークを修正
2022-11-18 Arduinojsonの追加開始
2022-11-18 Telecomを実装
2022-11-18 Configのダウンリンクを実装
2022-11-18 RSSI表示を実装
2022-11-18 メモリリークを修正
2022-11-18 .vscodeを追跡から除外
2022-11-18 キャッシュを削除
2022-11-18 不要なgitignoreを削除
2022-11-18 GPSをjsonに追加開始
2022-11-18 GPSをjsonに追加
2022-11-18 jsonの更新
2022-11-18 UNIX時刻、サーボ角度の追加
2022-11-18 json受信機能の追加
2022-11-18 epochTimeに変更
2022-11-19 テレメーターからの受信を実装
2022-11-19 valveを実装
2022-11-20 GPSを実装
2022-11-20 Timelineを実装
2022-11-20 Flightmodeを実装
2022-11-21 コンフィグのアップリンクを実装
2022-11-21 スラストモードを実装
2022-11-21 落下分散, コンフィグの初期値を更新
2022-11-22 シリアル通信でjsonが来てもフリーズしないように修正
2022-11-22 GPSのマーカーが中心になるように変更
2022-11-22 ログの出力を割り込み処理に変更
2022-11-22 ダウンリンクの発信処理を関数に分離
2022-11-24 jsonの修正
2022-11-24 割り込み処理完成
2022-11-24 servoのテスト用
2022-11-28 ダウンリンクの頻度を下げ、変更があればその都度送信するように変更
2022-11-28 コメントを追加
2022-11-29 使用しない部分の消去
2022-11-29 主流路と供給路の動作を異なるタイミングに変更
2022-11-29 別の動作方式の検証
2022-11-29 別の方法で検証開始
2022-11-30 タイミングをずらす機能以外完成
2022-11-30 サーボの速度を変化させる機能の追加
2022-12-04 細かい修正
2022-12-04 Statusのダウンリンク送信タイミングを修正
2022-12-04 RSSI表示を修正
2022-12-04 名称を変更 最短分離時間 -> 分離保護時間 最長分離時間 -> 強制分離時間
2022-12-04 指定高度分離を追加
2022-12-04 高度指定で分離を実装
2022-12-04 LANDモードを実装
2022-12-04 型を幅指定に変更
2022-12-04 分離信号を3.0秒後にOFFにするように変更
2022-12-04 ダウンリンクを非同期で送信するように変更
2022-12-04 ログを整理
2022-12-04 VarSpeedServoの導入
2022-12-05 Servo速度のコントロール部分を実装
2022-12-05 Confing表示の位置を変更
2022-12-05 Valveコントロール部の作成
2022-12-06 コールドフロー前試験完了
2022-12-06 Valve制御をValveContorol.inoに移植
2022-12-07 コメントの追加
2022-12-07 Servoの角度読み取り部の変更
2022-12-08 配置を変更
2022-12-08 デバッグ用の降下検知数のシリアル出力を追加
2022-12-08 Telecomをコンポーネント化
2022-12-08 SerialportSelectorを追加
2022-12-08 BlinkIndicatorを修正
2022-12-08 Configを移動
2022-12-08 Cinfigを整理
2022-12-08 コンポーネント化
2022-12-08 アセットのパスを修正
2022-12-08 加速度にローパスフィルタを実装
2022-12-09 ValveControlerにチャタリング対策を実装
2022-12-09 外部割込みの消去
2022-12-10 サーボ角度の送信をコードに戻しました
2022-12-10 初期状態をWatingポジションに変更
2022-12-10 MPU6050のラッパーライブラリを追加
2022-12-12 姿勢角算出をMadgwickフィルタで実装
2022-12-12 速度算出を実装
2022-12-12 AltitudeIndicatorを実装
2022-12-14 Jsonの調整
2022-12-14 deserializeJsonの追加
2022-12-14 GPS受信を待たずにLoRaでJsonを送信
2022-12-14 送信確認用LEDの追加
2022-12-14 magnetic variationとcourseの追加
2022-12-14 取得不可能な値をコメントアウト
2022-12-14 LoRa.beginの修正
2022-12-16 状態確認LEDの追加
2022-12-16 ArduinoJsonの調整
2022-12-17 電圧測定を実装
2022-12-17 UART通信機能の追加
2022-12-18 電圧表示を実装
2022-12-18 UART機能の更新
2022-12-18 燃焼実験用に改良
2022-12-18 不要なファイルの消去
2022-12-19 EEPROM_24xx1025を移植
2022-12-20 ダウンリンクをJsonからMsgPackに変更
2022-12-20 ダウンリンクにバッファを実装
2022-12-20 外部給電でも動作するように改良
2022-12-20 確認用LEDの追加
2022-12-21 StreamUtils.hの追加
2022-12-21 コールドフロー試験用に改良 コールドフロー試験CO2、N2Oともに成功
2022-12-23 燃焼実験用の設定に変更
2022-12-26 TransmitterにMsgPackの処理を追加
2022-12-26 アップリンクをMsgPackに変更
2022-12-26 GPSをGNSSに変更
2022-12-27 EEPROMの書き込みを実装
2022-12-30 EEPROM解析用のコンポーネントを追加
2022-12-30 イベント表示を実装
2023-01-09 速度表示を加速度表示に変更
2023-01-11 性能試験用に改良
2023-01-11 通信強度表示機能の追加
2023-01-11 EM用に改良
2023-01-11 Fill弁を用いたコールドフロー試験の成功
2023-01-12 ミッション表示を追加
2023-01-12 機体画像をにんじんに変更
2023-01-12 READMEを変更
2023-01-12 ガーバーデータを追加
2023-01-12 ハードウェアのREADMEを追加
2023-01-12 READMEにBuildの場所を追加
2023-01-12 生産者表示を追加
2023-01-15 不感帯に入りやすくなる現象の改善
2023-01-16 Nano用に使用するピンを変更 外部給電からの動作確認
2023-01-16 FM用にピン設定を変更
2023-01-16 LoRa周波数を40chに変更
2023-01-17 電圧表示を0Vは赤文字になるように変更
2023-01-17 バルブ角度の初期位置を修正
2023-01-19 FM仕様に変更
2023-01-19 コードを整形
2023-01-19 ピンを抽象化
2023-01-19 IMUを抽象化
2023-01-19 高度算出を抽象化
2023-01-19 データダンプモードを実装
2023-01-20 GNSSで不正な座標を受信したときにクラッシュする問題を修正
2023-01-20 バッテリー残量表示を追加
2023-01-20 メニューを削除
2023-01-20 tsxをコンポーネント化
2023-01-20 初回起動時に基準気圧が不正な値になる問題を修正
2023-01-20 キャリブレーションを分離
2023-01-20 気圧と気温をログに追加
2023-01-20 連続降下回数がログに反映されなかった問題を修正
2023-01-20 周波数帯をARIB Channel 30に変更
2023-01-20 Arduino NANO用設定を追加
2023-01-20 不要な箇所を訂正
2023-01-20 コメント文の修正
2023-01-20 アスキーアートの追加
2023-01-20 外部モニター用にサイズを修正
2023-01-21 パラシュートモードでも強制分離信号を出すように変更
2023-01-21 READMEに起動モードを追加
2023-01-21 READMEを更新
2023-01-21 READMEを修正
2023-01-21 IntervalCounterとOneShotTimerをTaskManagerに統一
2023-01-22 ログに電圧を追加
2023-01-23 コンポーネントのサイズを調整
2023-01-23 背景を地図に変更
2023-01-23 色を変更
2023-01-23 GNSSを中央下に移動
2023-01-23 打ち上げ場所のアイコンを変更
2023-01-23 AltitudeIndicatorを改良
2023-01-23 降下検知の感度を変更
    [log.xlsx]
2023-01-23 指数をいい感じに表示
2023-01-24 初期コンフィグを更新
2023-01-24 安全審査書用の資料を追加
    [log.xlsx]
2023-01-24 Swagelockバルブシステムへ対応
2023-01-24 GNSSサンプリングレートを1Hzに変更
2023-01-24 サンプリングレートの変更
2023-01-24 サーボモーター動作の不具合修正
2023-01-24 不具合修正
2023-01-25 進捗表示を修正
2023-01-25 コンフィグを更新
2023-01-25 GNSSの位置を調整
2023-01-25 IMUのオフセットを更新
2023-01-26 LEDピンの追加
2023-01-27 オフラインでも地図が表示されるように変更
2023-01-27 受信時にLEDを点灯させるように変更
2023-01-28 共通計器の受信側ボーレートが500000だったので115200に修正
2023-01-29 Swagelockバルブ燃焼実験の為に調整
2023-01-30 イベントのDESCENTをAPOGEEに変更
2023-01-30 指定分離高度が0mの場合は頂点分離するように変更
2023-02-01 READMEの追加
2023-02-01 スペルミスの解消
2023-02-01 READMEの画像パスを修正
2023-02-01 姿勢表示の位置を修正
2023-02-01 READMEの更新
2023-02-01 工事中をGIFに変更
2023-02-01 作業手順書を追加
    [log.xlsx]
2023-02-01 補足の動作テスト
2023-02-01 こちらから飛べるように変更
2023-02-01 作業手順書の更新
2023-02-01 手順書を更新しただも。
2023-02-01 Manualの更新
2023-02-02 バルブコントローラーManualの追加と更新
2023-02-02 各種マニュアルの更新
2023-02-02 マニュアルの更新
2023-02-02 :point_left:ヨシ！の追加
2023-02-02 READMEの更新および帰宅
2023-02-02 TSRPマークの追加
2023-02-02 TSRPマークの修正
2023-02-03 GNSSの位置を変更
2023-02-03 ログ形式を修正
2023-02-03 プログラムの解説を追加
2023-02-05 プログラムの詳細を追加
2023-02-05 スペルミスの修正
2023-02-05 READMEに画像を挿入
2023-02-07 プログラムの解説を更新
2023-02-07 プログラム解説を修正
2023-02-07 ダウンリンク周りの命名を変更
2023-02-07 イベントをuint8_tで送信するように変更
2023-02-07 頂点分離設定かを返す明示的な関数を追加
2023-02-07 電圧表示を修正
2023-02-08 フライトピン開放中は1秒おきにビープ音を鳴らすように変更
2023-02-11 リハ1のコンフィグを設定
    [log.csv, log.xlsx]
2023-02-11 座標のDMS表示がずれる問題を修正
2023-02-11 マップタイルを全部追加
2023-02-11 Display表示機能を追加してみたい。
2023-02-11 緊急時に供給路を開にするもの
2023-02-11 バルブ表示の角度を変更
2023-02-13 手動緊急分離を実装
2023-02-14 緊急手動分離を修正ヨシ！
2023-02-14 燃焼時間をモータ動作時間に変更
2023-02-14 イベントの受信を修正
2023-02-14 物品リストの追加
2023-02-14 物品リストのリンクを埋め込み
2023-02-14 リストの更新及び出力
2023-02-14 Listの更新
2023-02-15 リハーサル2のコンフィグを設定
2023-02-16 イベント通知が二重で出ていた問題を修正
2023-02-16 Add files via upload
    本日2/16に書き込んだ分です。
2023-02-17 リストの更新
2023-02-17 リストの更新及びPDF化
2023-02-21 RomDumperを更新
2023-02-22 フォーマッターが賢くなった！
2023-02-22 機体の画像を更新
2023-02-22 配列のレンダリングにキーを追加
2023-02-26 ダウンリンクの保存を追加（飛行機の中なのでデバッグはできない）
2023-02-26 フライトピンが解放された状態で起動しても離床判定しないように変更（飛行機の中ゆえデバッグ不可）
2023-02-26 前コミットの内容を改良
2023-02-27 フライトピンが開放された状態で起動した時は離床判定しないを修正
2023-02-27 SDカードへのログ出力を修正
2023-02-27 ログ保存を非表示に変更
2023-02-27 logの初期値をundifindに変更
2023-02-28 2月28日現地リハのコンフィグを設定
2023-03-01 3月1日現地リハ2のコンフィグを設定
2023-03-01 GPS座標の初期値を変更
2023-03-01 RSSIを常に表示するように変更
2023-03-01 上昇率表示を追加
2023-03-01 useEffectを分離
2023-03-01 TelecomをCommunicationに改名
2023-03-01 フライトモードの初期値を非表示に変更
2023-03-01 useEffectの購読解除を修正
2023-03-01 GNSSのエポックタイム表示を追加
2023-03-01 フライトモードにシャットダウンモードを追加
2023-03-01 エポックタイムの初期値を修正
2023-03-02 飛行進捗表示を修正
2023-03-02 GNSSのエポックタイム表示を修正
2023-03-02 分離コンフィグを更新
2023-03-02 地上局のログ出力を修正
2023-03-03 3月4日打ち上げのおはようコンフィグを設定
2023-03-04 不正が座標を受信してもエラーを吐かないように修正
2023-03-04 解析情報置き場を追加
2023-03-04 フライトログを追加
    [flight.csv]
2023-03-10 解析資料を追加
    [VerticalVelocity.csv]
2023-03-10 解析資料を修正
    [FlightLog.xlsx]
2023-03-10 解析資料を更新
2023-03-10 H-57 GNSSログを追加
2023-03-10 グラフを追加
    [Altitude.csv]
2023-03-10 ログ写真の場所を変更
2023-03-10 GNSSについての考察を追加
2023-03-10 GNSSについての更新
2023-03-12 FlyingCarrotを追加
    [const.csv, f1ranking2018.csv, flight.csv, lan.csv, lantable.csv, sample.csv]
2023-03-13 RomDumperを修正
2023-03-13 解析資料に頂点検出, 気温, SD, EEPROMを追記
    [FlightLog.xlsx, flight_eeprom.csv]
2023-03-13 いかがでしたか？
2023-03-13 基板の写真を追加
2023-03-13 いい感じのバナーを追加
2023-03-13 バナーを修正
2023-03-14 バルブコントロールモジュールについての記述を追加
2023-03-14 アンビリカルケーブルについての記述を追加
2023-03-14 コメントを更新
2023-03-14 文書の微修正
2023-03-16 電源について記載
    [FlightLog.xlsx]
2023-03-16 電源について修正
2023-03-16 文章を修正
2023-03-17 ボールバルブ、電源について記述を追加
2023-03-17 まとめの追加
2023-03-17 アンビリカルケーブルについてのまとめを追加
2023-03-18 加速度解析を追加
    [FlightLog.xlsx, Integral.xlsx]
2023-03-20 解析資料の構成を修正
2023-03-20 解析資料に速度・変位について追加
2023-03-20 解析資料をpdfに書き出し
2023-03-20 Listの埋め込みを更新
2023-03-20 解析資料にGithubへの誘導を追加
2023-03-20 QRコードを修正
2023-03-20 PDFを再書き出し
2023-03-23 Motionを更新
    [Integral.xlsx, Thrust.xlsx, flight.csv]
2023-10-12 いい感じのバッジを追加
2023-10-12 READMEに簡単な説明を追加
2023-10-12 📝READMEの修正を行いました．
