tokai-student-rocket-project/H-57-Avionics/FlightComponents/Telemeter/docs/Manual_ValveContoroler_Tower.JPG

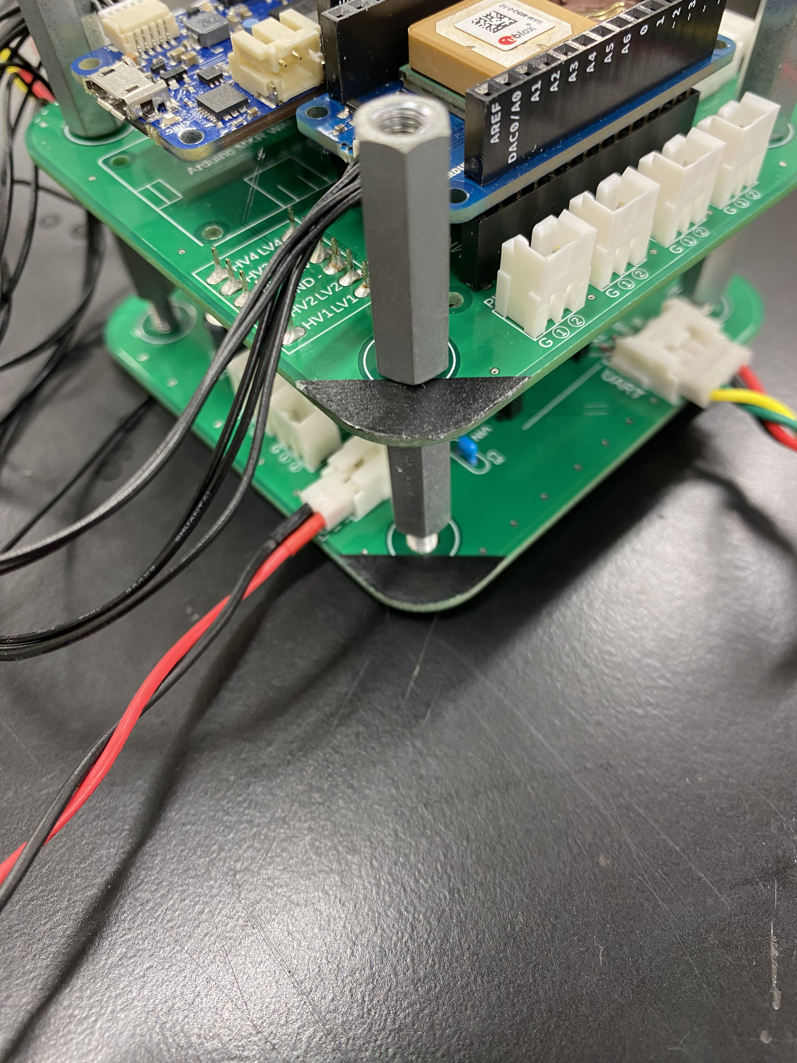
[picture p47: FlightComponents/Telemeter/docs/images/Manual_ValveController_Tower.JPG]
FlightComponents/Telemeter/docs/Manual_ValveContoroler_Tower.JPG
